sparkle-unitn/ELS-overall_schematic/README.md

# ELS-overall_schematic
Overall schematic of SpARKLE electronic subsystem
