sparkle-unitn/ELS-overall_schematic/ELS-overall_schematic.pdf

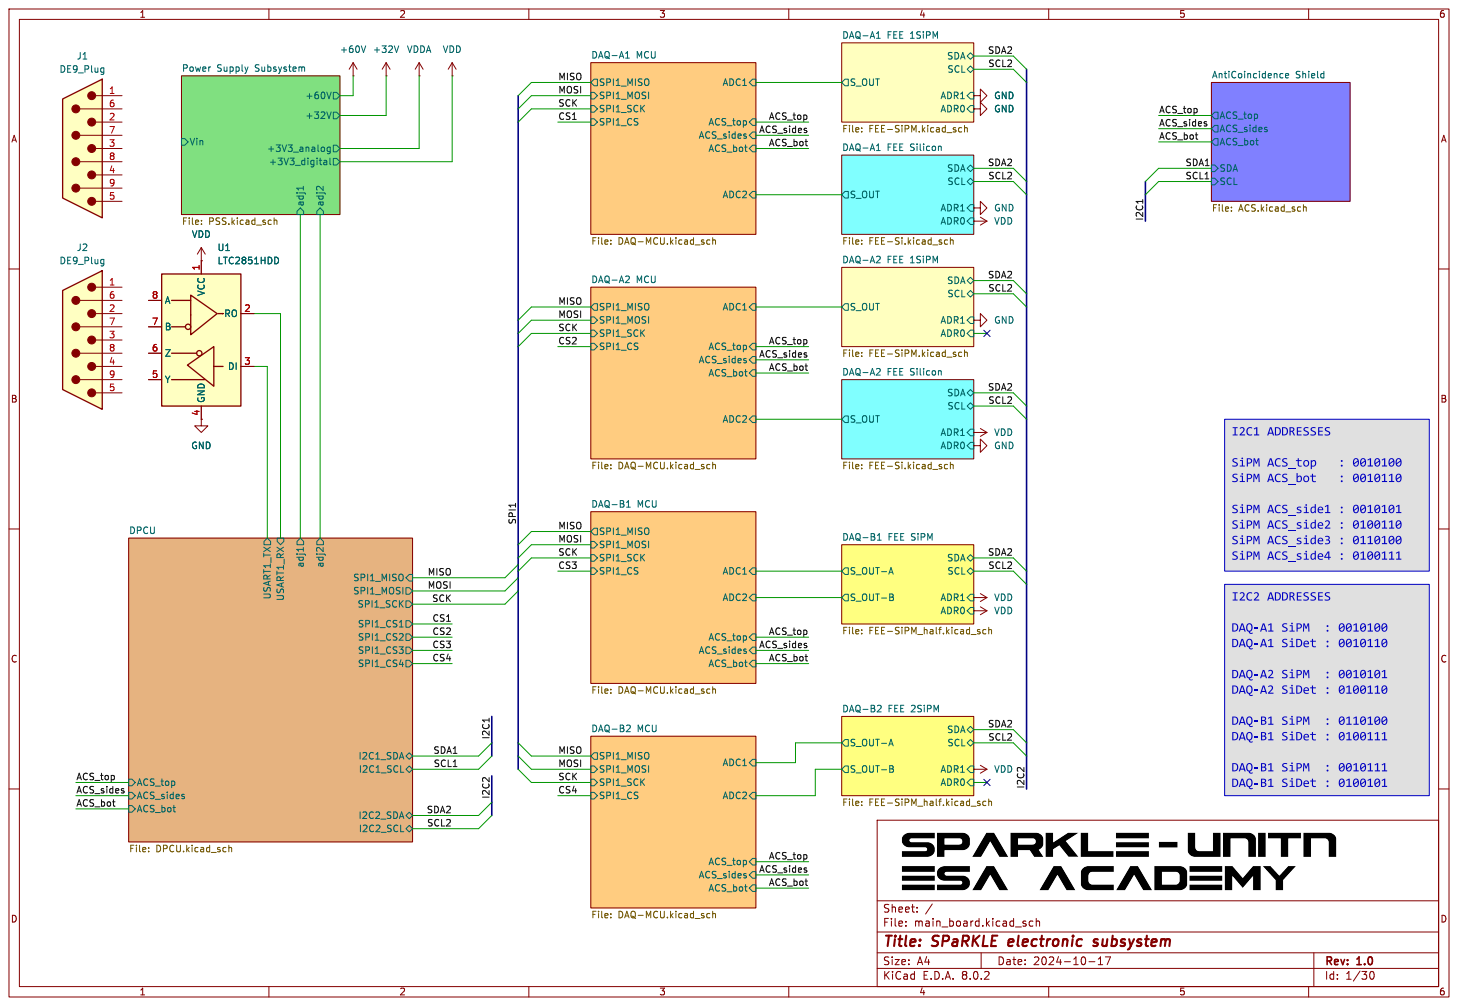
[picture p1: page 1]

Vin Power Supply Subsystem

SCL ADR0 ADR1 DAQ-A2 FEE Silicon File: FEE-Si.kicad_sch SCL SDA

Id: 1/30 Title: SPaRKLE electronic subsystem

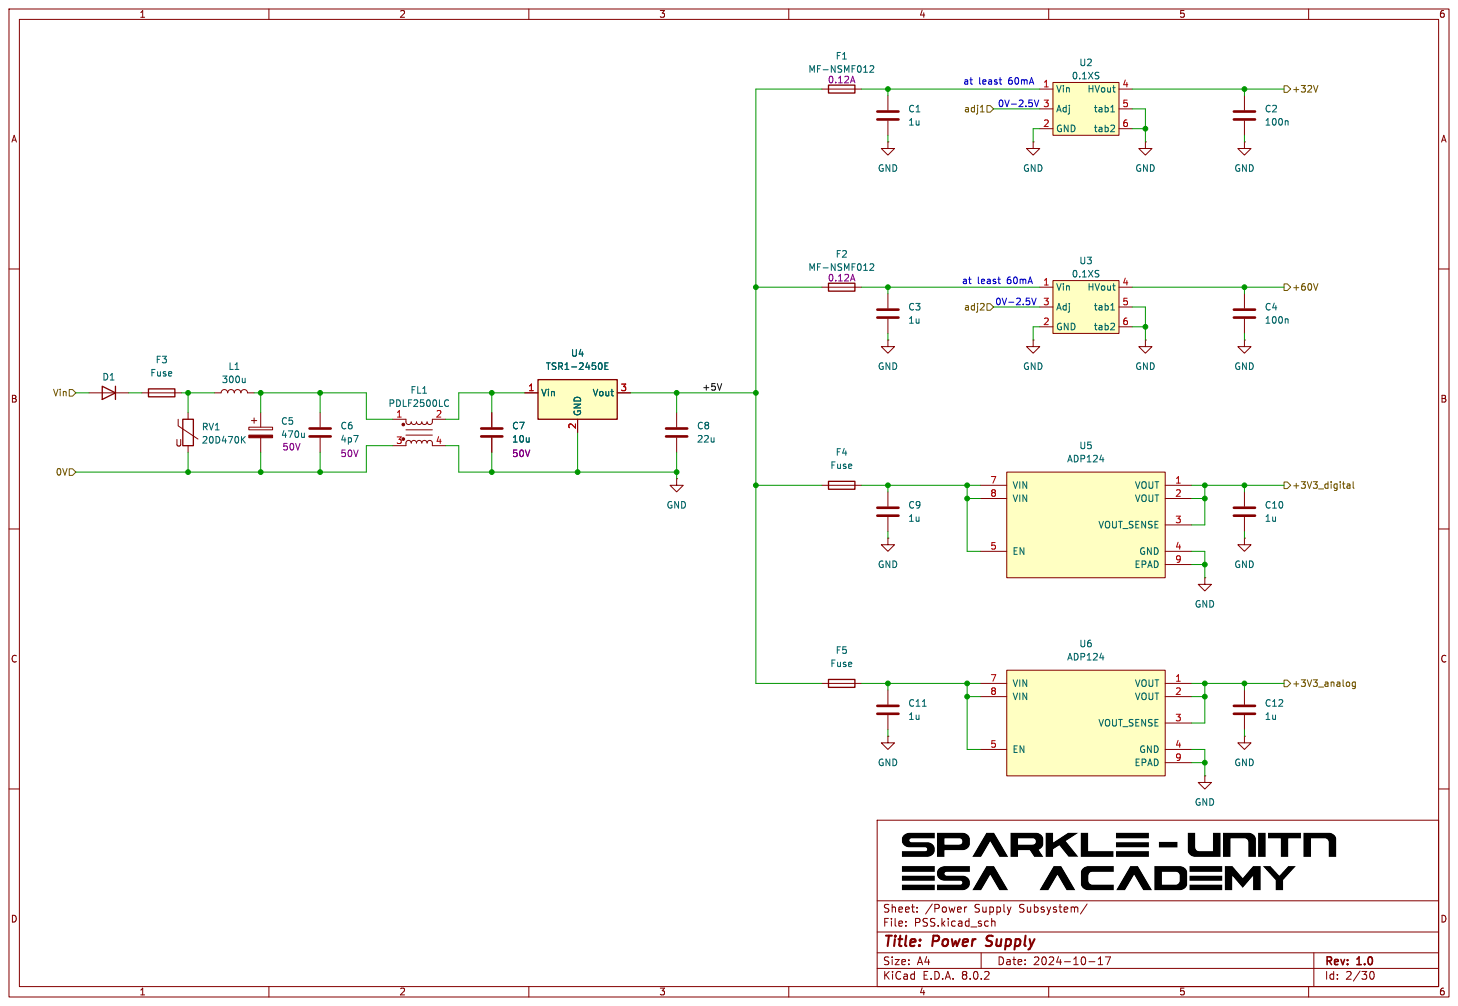
[picture p2: page 2]

Id: 2/30 Title: Power Supply

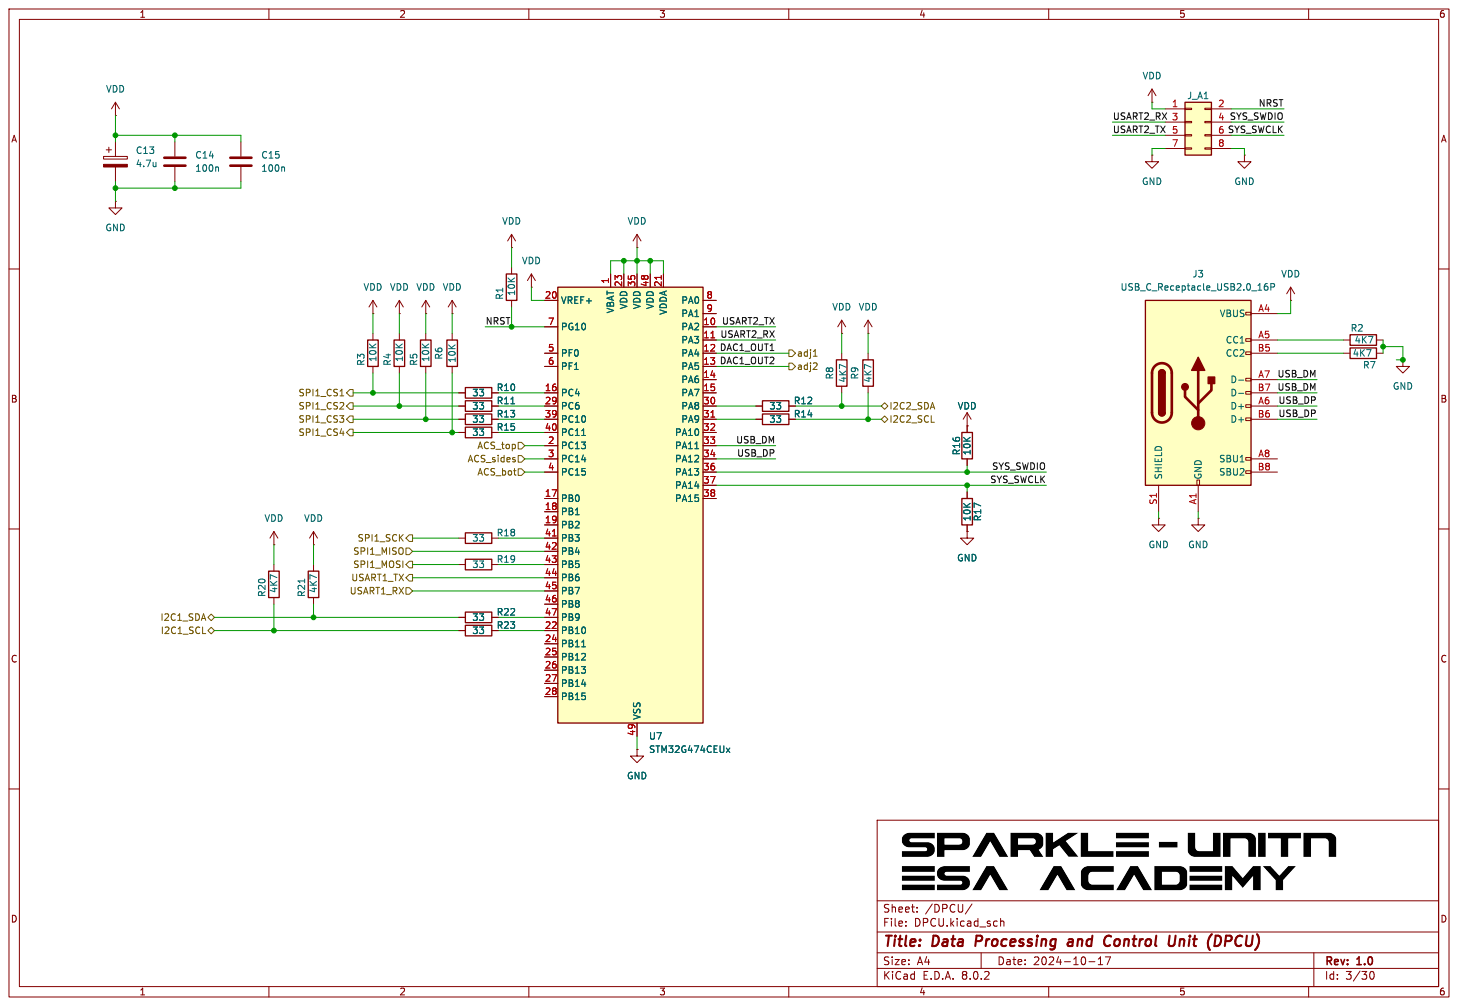
[picture p3: page 3]

1 PA2 10 PA3 11 PA4 12 PA5 13 PA6 14 PA7 15 PC4 16 PB0 17 PB1 18 PB2 19 PC13 2 VREF+ 20 VDDA 21 PB10 22 VDD 23 PB11 24 PB12 25 PB13 26 PB14 27 PB15 28 PC6 29 PC14 3 PA8 30 PA9 31 PA10 32 PA11 33 PA12 34 VDD 35 PA13 36 PA14 37 PA15 38 PC10 39 PC15 4 PC11 40 PB3 41 PB4 42 PB5 43 PB6 44 PB7 45 PB8 46 PB9 47 VDD 48 VSS 49 PF0 5 PF1 6 PG10 7 PA0 8 PA1 9 U7STM32G474CEUx

1 PA2 10 PA3 11 PA4 12 PA5 13 PA6 14 PA7 15 PC4 16 PB0 17 PB1 18 PB2 19 PC13 2 VREF+ 20 VDDA 21 PB10 22 VDD 23 PB11 24 PB12 25 PB13 26 PB14 27 PB15 28 PC6 29 PC14 3 PA8 30 PA9 31 PA10 32 PA11 33 PA12 34 VDD 35 PA13 36 PA14 37 PA15 38 PC10 39 PC15 4 PC11 40 PB3 41 PB4 42 PB5 43 PB6 44 PB7 45 PB8 46 PB9 47 VDD 48 VSS 49 PF0 5 PF1 6 PG10 7 PA0 8 PA1 9 R14 33 R12 33 GND

Id: 3/30 Title: Data Processing and Control Unit (DPCU) File: DPCU.kicad_sch Sheet: /DPCU/

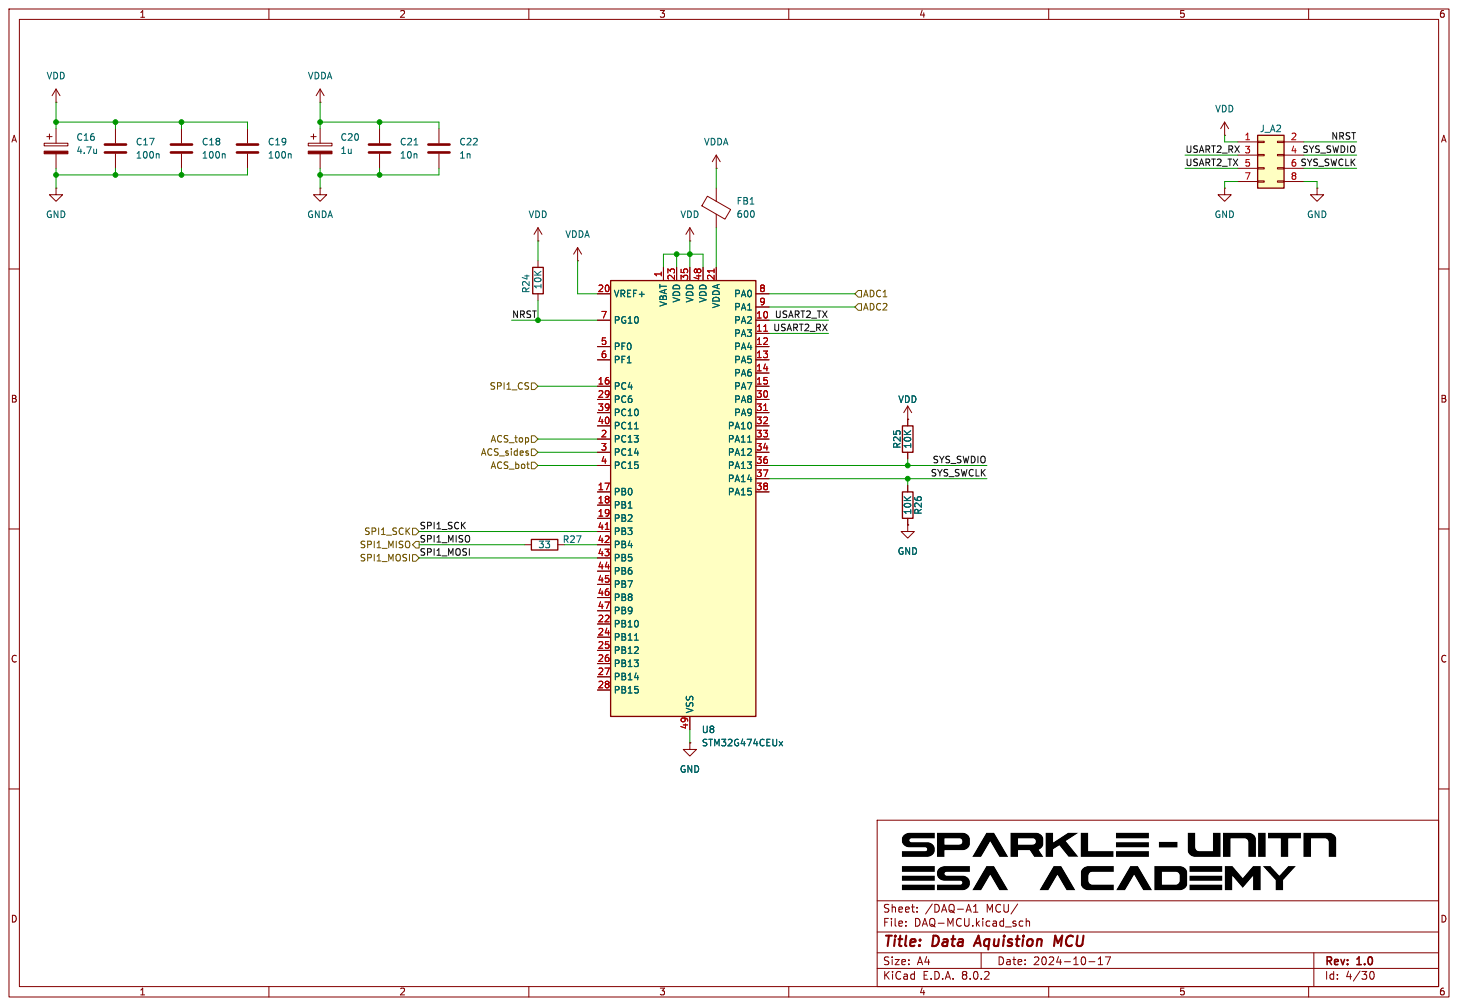
[picture p4: page 4]

1 PA2 10 PA3 11 PA4 12 PA5 13 PA6 14 PA7 15 PC4 16 PB0 17 PB1 18 PB2 19 PC13 2 VREF+ 20 VDDA 21 PB10 22 VDD 23 PB11 24 PB12 25 PB13 26 PB14 27 PB15 28 PC6 29 PC14 3 PA8 30 PA9 31 PA10 32 PA11 33 PA12 34 VDD 35 PA13 36 PA14 37 PA15 38 PC10 39 PC15 4 PC11 40 PB3 41 PB4 42 PB5 43 PB6 44 PB7 45 PB8 46 PB9 47 VDD 48 VSS 49 PF0 5 PF1 6 PG10 7 PA0 8 PA1 9 U8STM32G474CEUx

1 PA2 10 PA3 11 PA4 12 PA5 13 PA6 14 PA7 15 PC4 16 PB0 17 PB1 18 PB2 19 PC13 2 VREF+ 20 VDDA 21 PB10 22 VDD 23 PB11 24 PB12 25 PB13 26 PB14 27 PB15 28 PC6 29 PC14 3 PA8 30 PA9 31 PA10 32 PA11 33 PA12 34 VDD 35 PA13 36 PA14 37 PA15 38 PC10 39 PC15 4 PC11 40 PB3 41 PB4 42 PB5 43 PB6 44 PB7 45 PB8 46 PB9 47 VDD 48 VSS 49 PF0 5 PF1 6 PG10 7 PA0 8 PA1 9 GND10K R26 VDD R25 10K

Id: 4/30 Title: Data Aquistion MCU

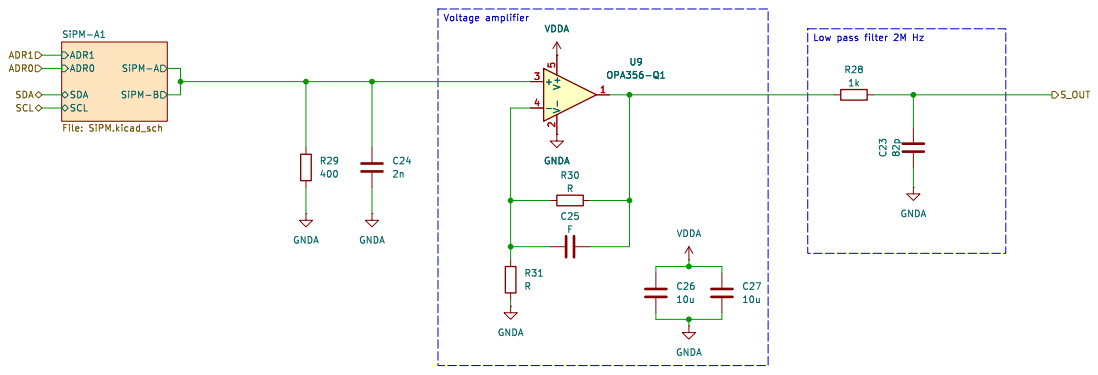
[picture p5: page 5]

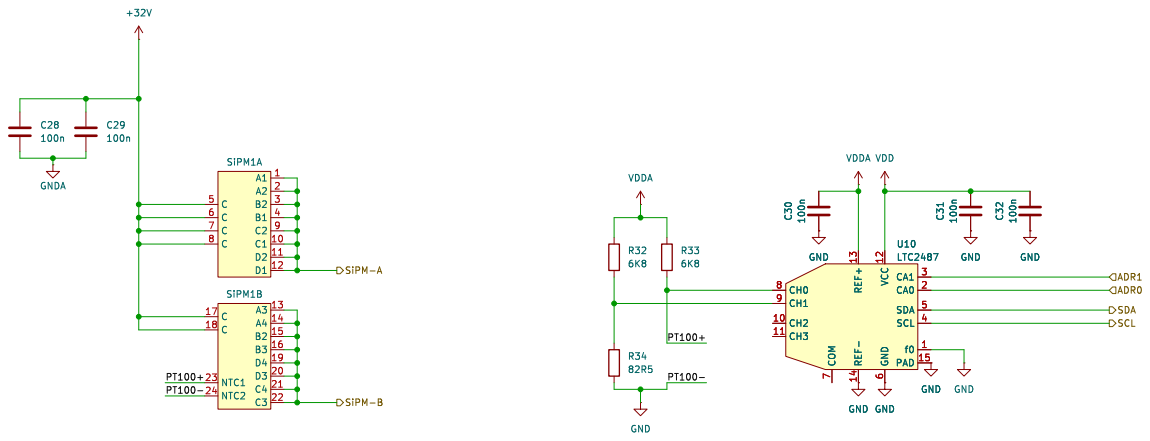
[picture p6: page 6]

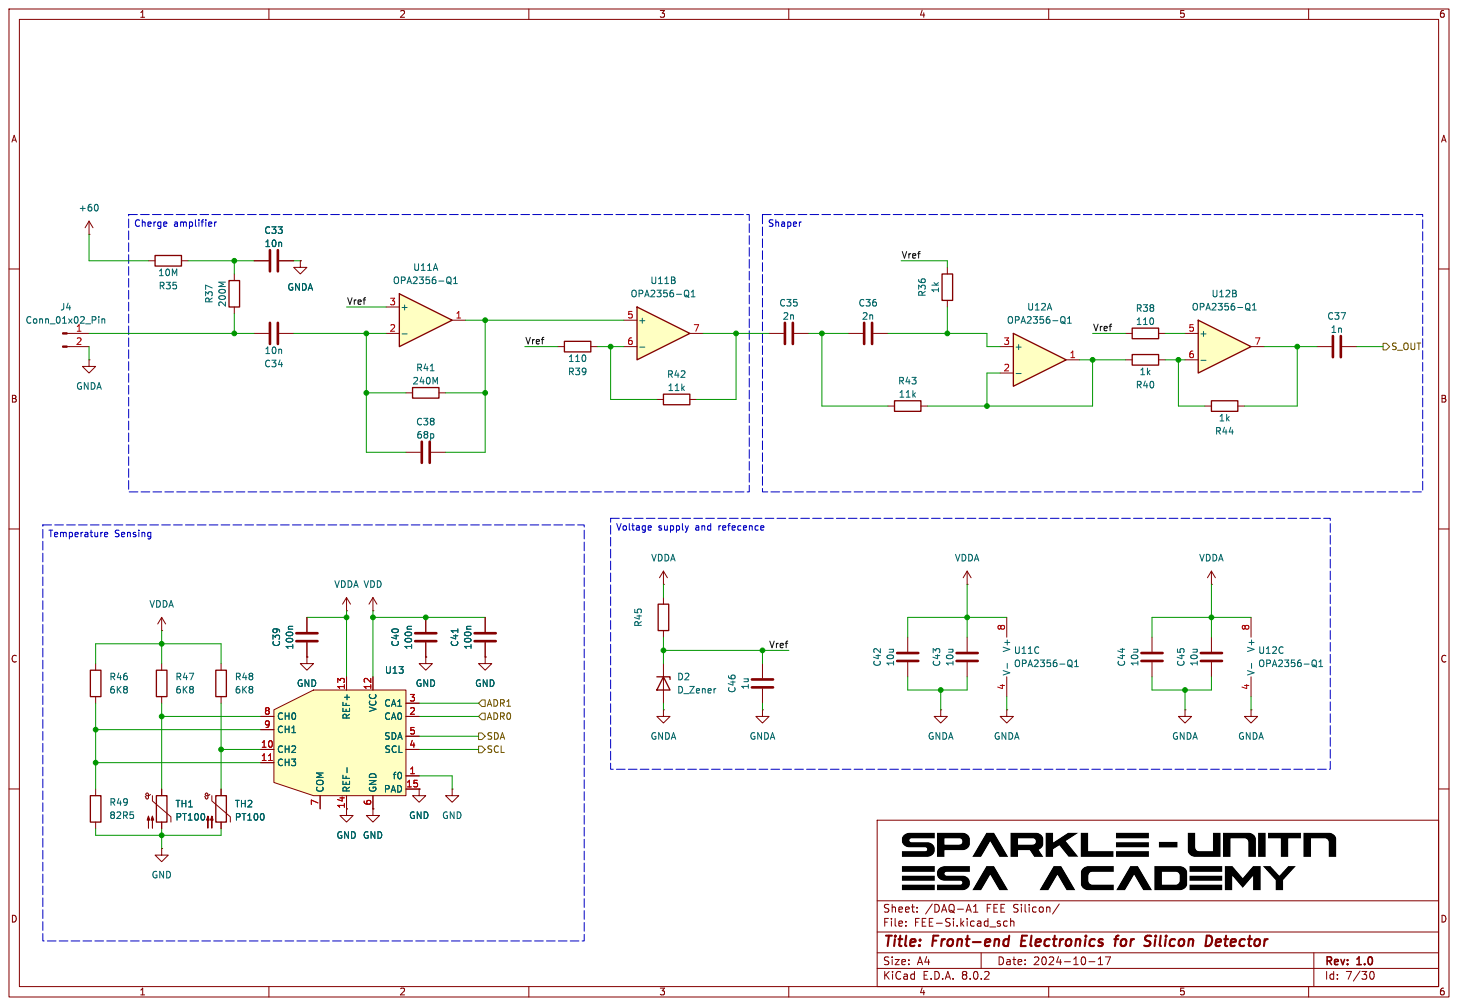
[picture p7: page 7]

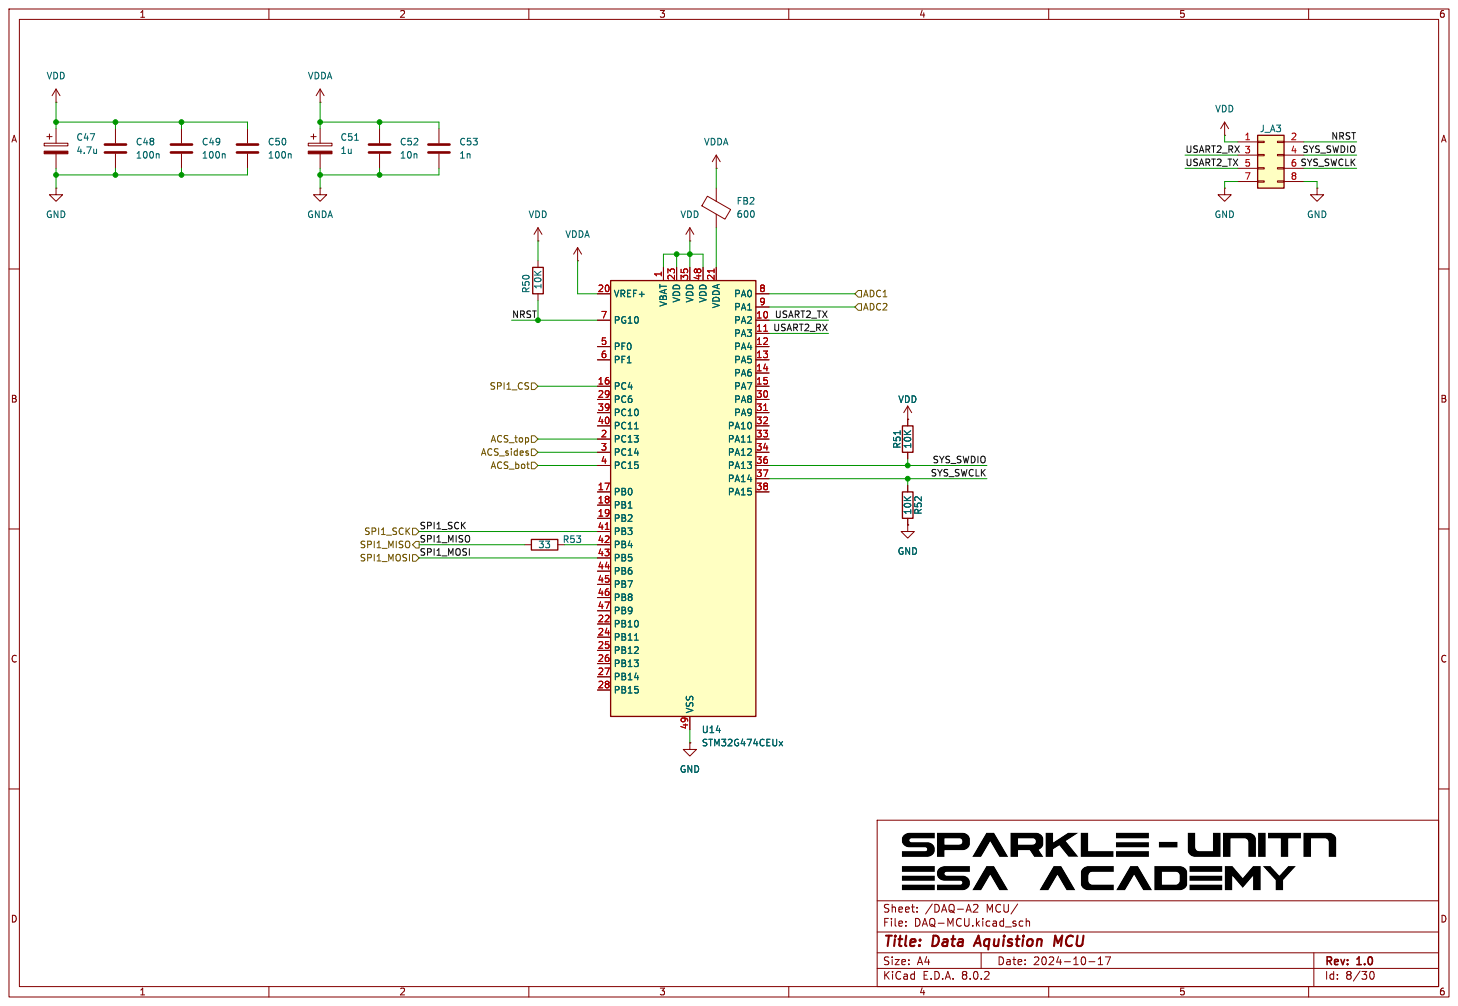
[picture p8: page 8]

1 PA2 10 PA3 11 PA4 12 PA5 13 PA6 14 PA7 15 PC4 16 PB0 17 PB1 18 PB2 19 PC13 2 VREF+ 20 VDDA 21 PB10 22 VDD 23 PB11 24 PB12 25 PB13 26 PB14 27 PB15 28 PC6 29 PC14 3 PA8 30 PA9 31 PA10 32 PA11 33 PA12 34 VDD 35 PA13 36 PA14 37 PA15 38 PC10 39 PC15 4 PC11 40 PB3 41 PB4 42 PB5 43 PB6 44 PB7 45 PB8 46 PB9 47 VDD 48 VSS 49 PF0 5 PF1 6 PG10 7 PA0 8 PA1 9 U14 STM32G474CEUx

1 PA2 10 PA3 11 PA4 12 PA5 13 PA6 14 PA7 15 PC4 16 PB0 17 PB1 18 PB2 19 PC13 2 VREF+ 20 VDDA 21 PB10 22 VDD 23 PB11 24 PB12 25 PB13 26 PB14 27 PB15 28 PC6 29 PC14 3 PA8 30 PA9 31 PA10 32 PA11 33 PA12 34 VDD 35 PA13 36 PA14 37 PA15 38 PC10 39 PC15 4 PC11 40 PB3 41 PB4 42 PB5 43 PB6 44 PB7 45 PB8 46 PB9 47 VDD 48 VSS 49 PF0 5 PF1 6 PG10 7 PA0 8 PA1 9 GND10K R52 VDD R51 10K

Id: 8/30 Title: Data Aquistion MCU

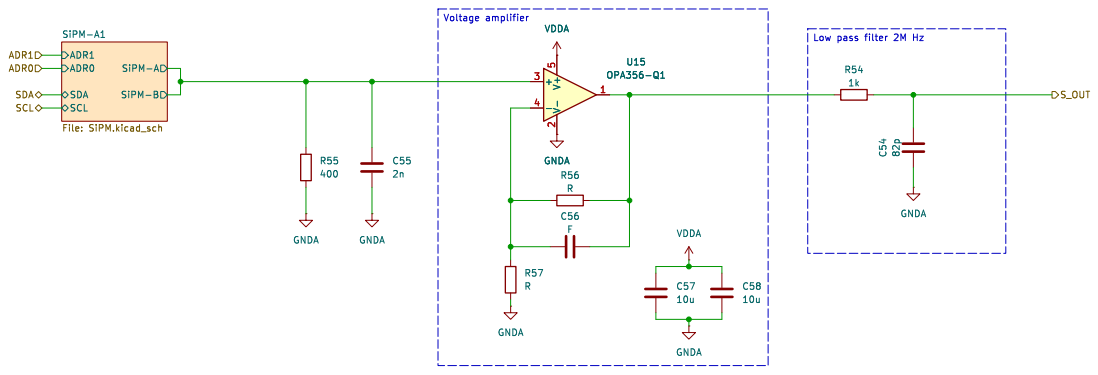
[picture p9: page 9]

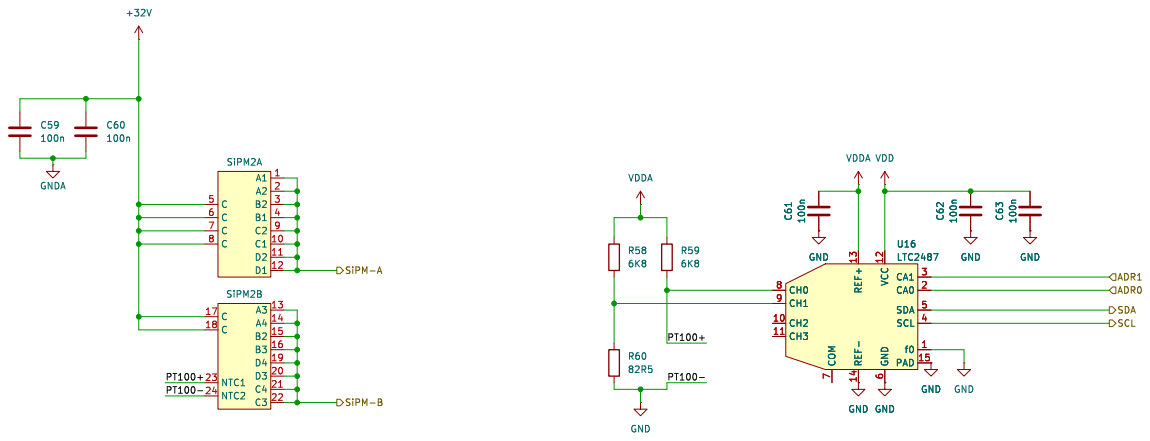
[picture p10: page 10]

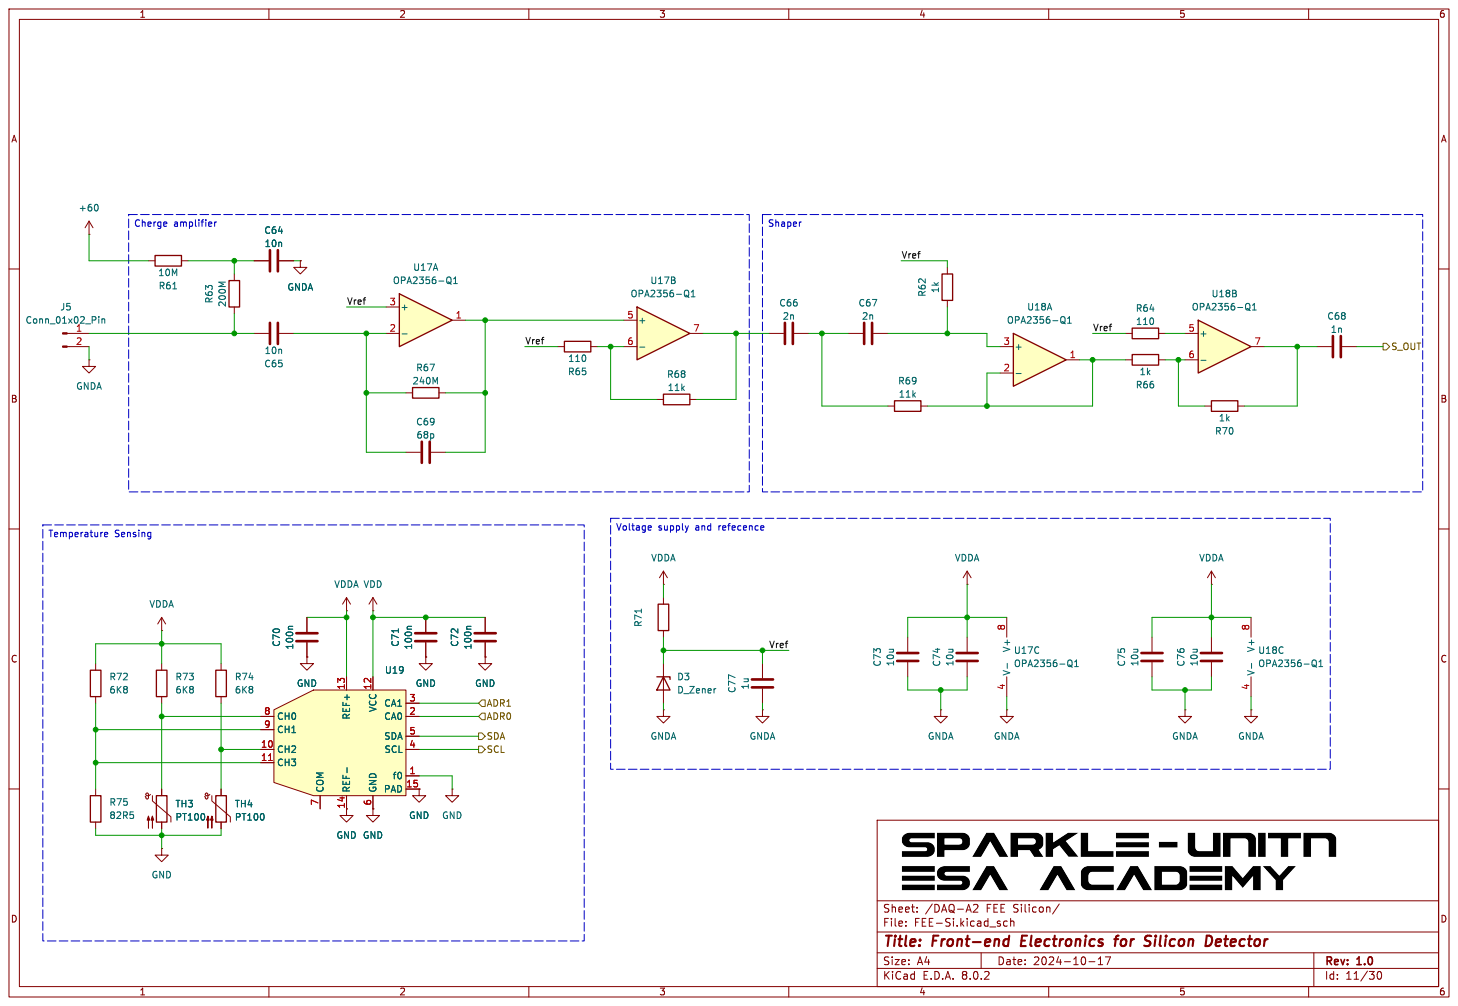
[picture p11: page 11]

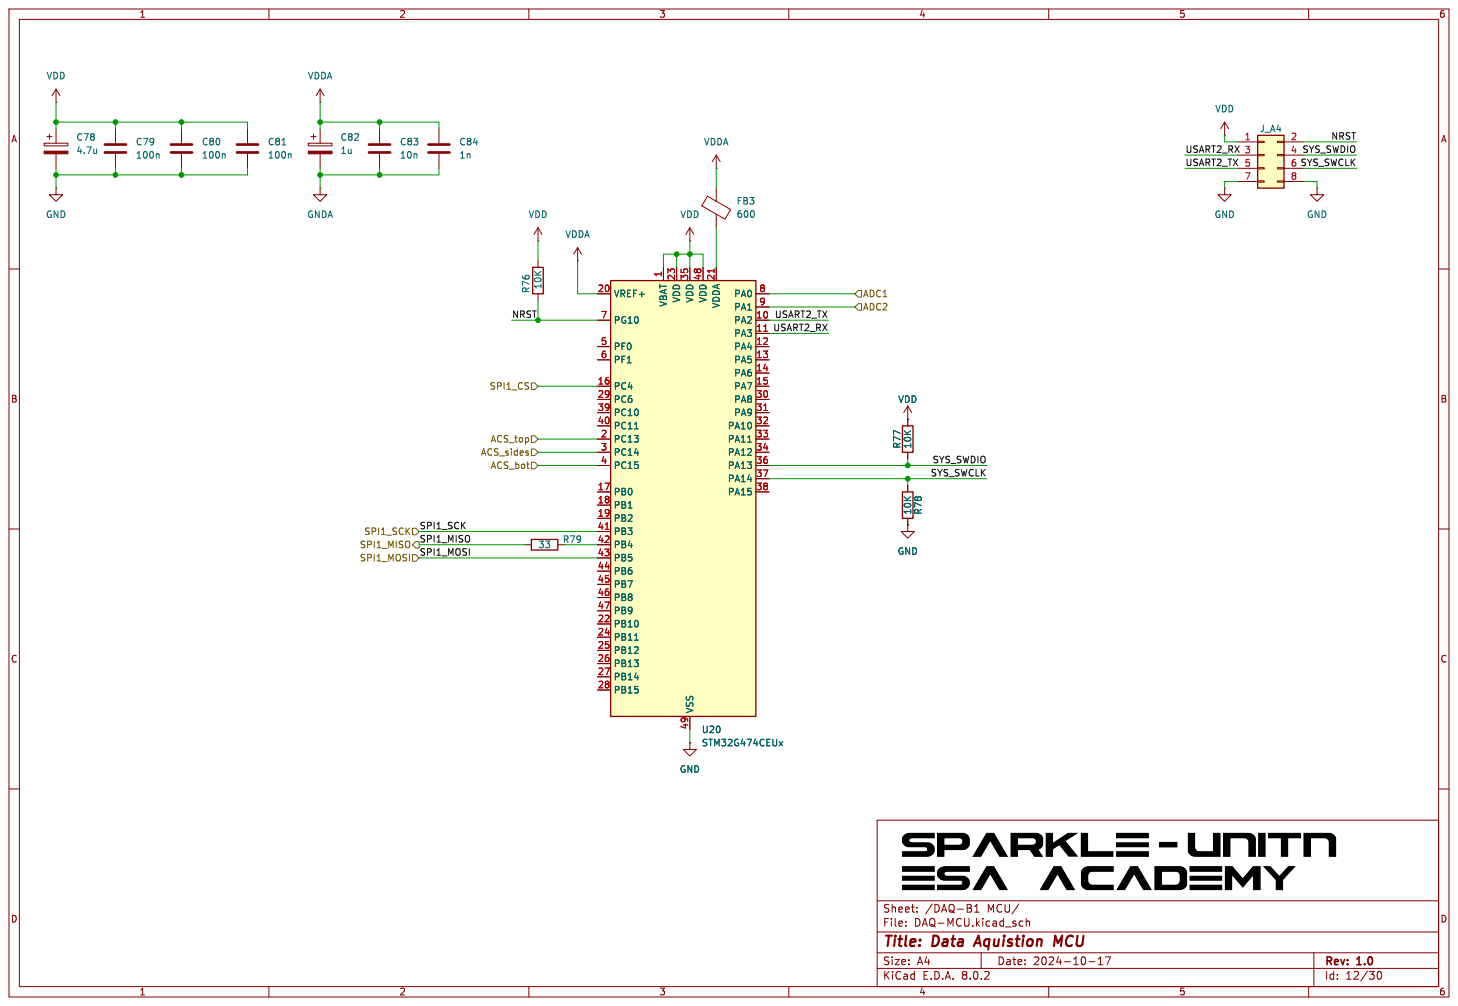
[picture p12: page 12]

1 PA2 10 PA3 11 PA4 12 PA5 13 PA6 14 PA7 15 PC4 16 PB0 17 PB1 18 PB2 19 PC13 2 VREF+ 20 VDDA 21 PB10 22 VDD 23 PB11 24 PB12 25 PB13 26 PB14 27 PB15 28 PC6 29 PC14 3 PA8 30 PA9 31 PA10 32 PA11 33 PA12 34 VDD 35 PA13 36 PA14 37 PA15 38 PC10 39 PC15 4 PC11 40 PB3 41 PB4 42 PB5 43 PB6 44 PB7 45 PB8 46 PB9 47 VDD 48 VSS 49 PF0 5 PF1 6 PG10 7 PA0 8 PA1 9 U20 STM32G474CEUx

1 PA2 10 PA3 11 PA4 12 PA5 13 PA6 14 PA7 15 PC4 16 PB0 17 PB1 18 PB2 19 PC13 2 VREF+ 20 VDDA 21 PB10 22 VDD 23 PB11 24 PB12 25 PB13 26 PB14 27 PB15 28 PC6 29 PC14 3 PA8 30 PA9 31 PA10 32 PA11 33 PA12 34 VDD 35 PA13 36 PA14 37 PA15 38 PC10 39 PC15 4 PC11 40 PB3 41 PB4 42 PB5 43 PB6 44 PB7 45 PB8 46 PB9 47 VDD 48 VSS 49 PF0 5 PF1 6 PG10 7 PA0 8 PA1 9 GND10K R78 VDD R77 10K

Id: 12/30 Title: Data Aquistion MCU

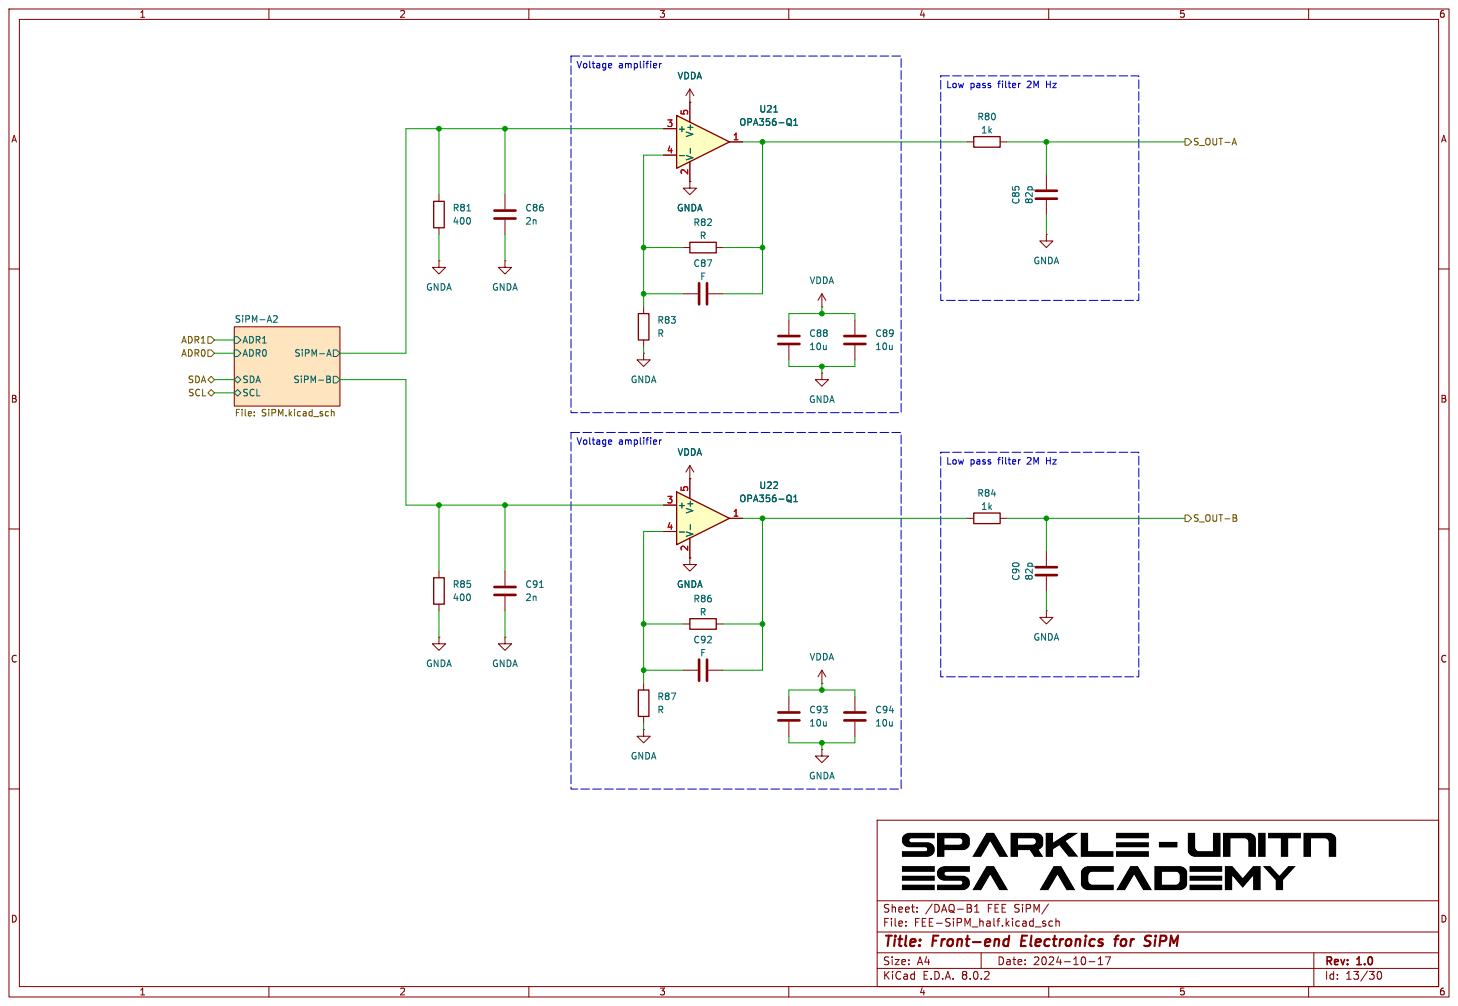
[picture p13: page 13]

Low pass filter 2M Hz U21 OPA356-Q1 V- 2 V+

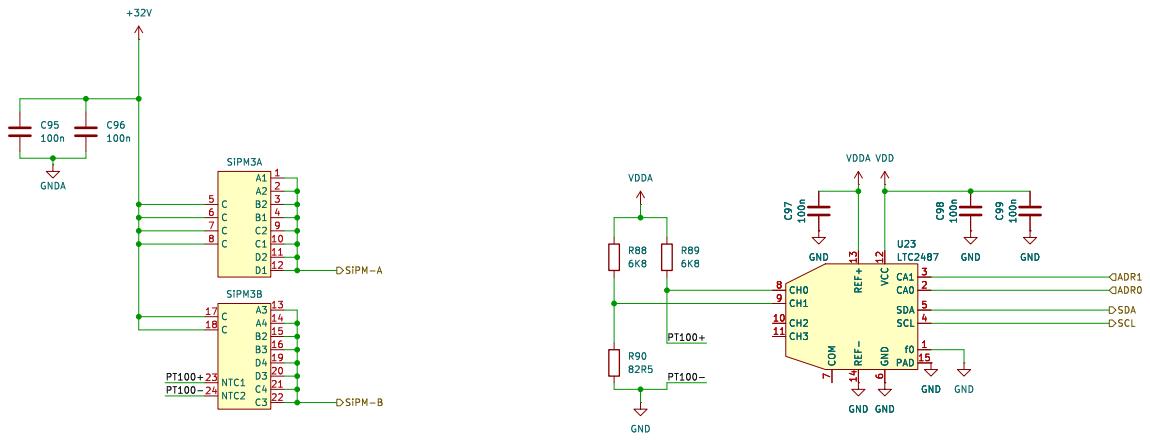
[picture p14: page 14]

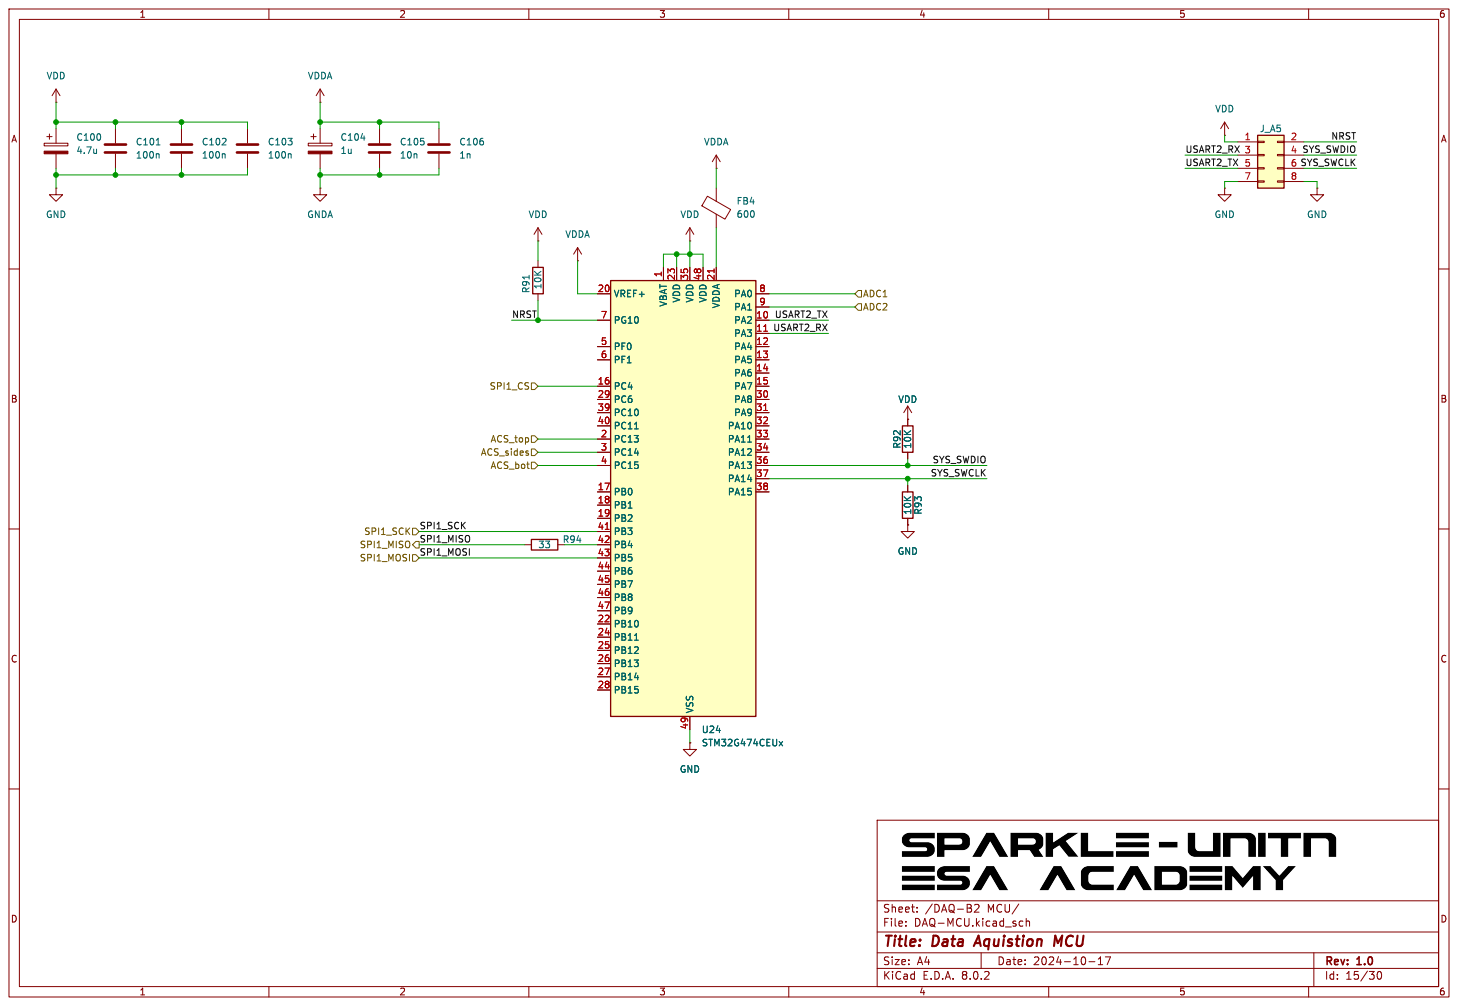
[picture p15: page 15]

1 PA2 10 PA3 11 PA4 12 PA5 13 PA6 14 PA7 15 PC4 16 PB0 17 PB1 18 PB2 19 PC13 2 VREF+ 20 VDDA 21 PB10 22 VDD 23 PB11 24 PB12 25 PB13 26 PB14 27 PB15 28 PC6 29 PC14 3 PA8 30 PA9 31 PA10 32 PA11 33 PA12 34 VDD 35 PA13 36 PA14 37 PA15 38 PC10 39 PC15 4 PC11 40 PB3 41 PB4 42 PB5 43 PB6 44 PB7 45 PB8 46 PB9 47 VDD 48 VSS 49 PF0 5 PF1 6 PG10 7 PA0 8 PA1 9 U24 STM32G474CEUx

1 PA2 10 PA3 11 PA4 12 PA5 13 PA6 14 PA7 15 PC4 16 PB0 17 PB1 18 PB2 19 PC13 2 VREF+ 20 VDDA 21 PB10 22 VDD 23 PB11 24 PB12 25 PB13 26 PB14 27 PB15 28 PC6 29 PC14 3 PA8 30 PA9 31 PA10 32 PA11 33 PA12 34 VDD 35 PA13 36 PA14 37 PA15 38 PC10 39 PC15 4 PC11 40 PB3 41 PB4 42 PB5 43 PB6 44 PB7 45 PB8 46 PB9 47 VDD 48 VSS 49 PF0 5 PF1 6 PG10 7 PA0 8 PA1 9 GND10K R93 VDD R92 10K

Id: 15/30 Title: Data Aquistion MCU

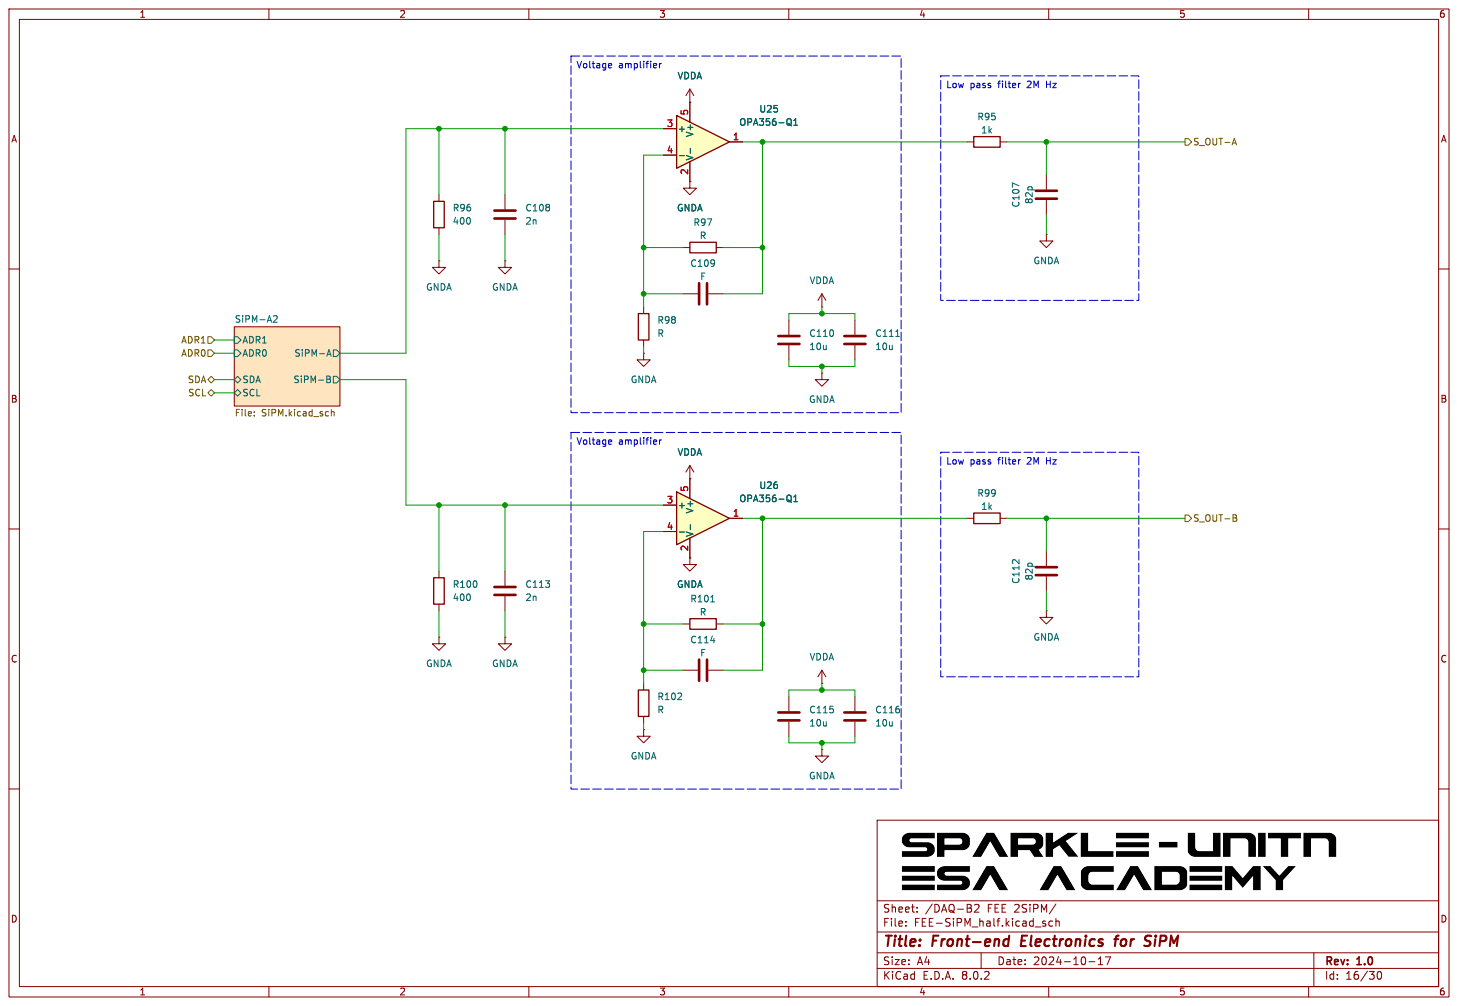
[picture p16: page 16]

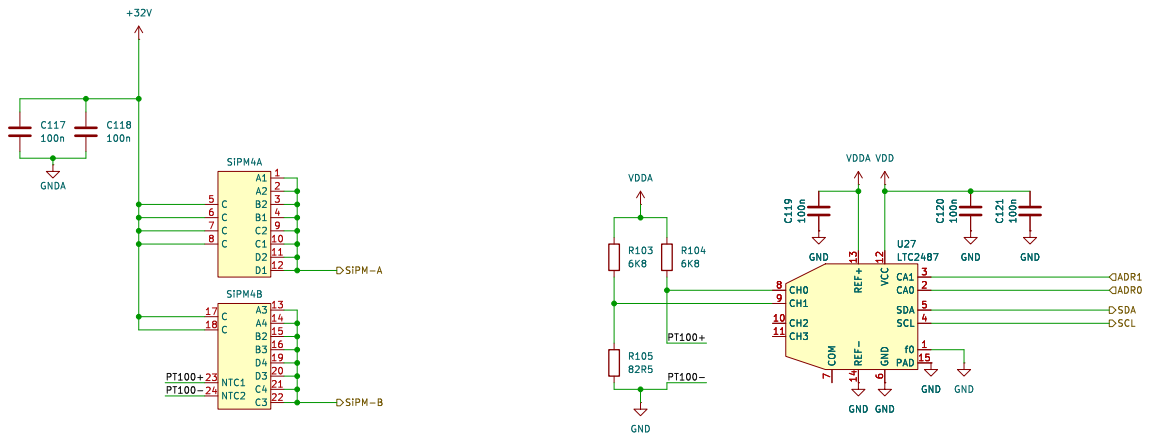
[picture p17: page 17]

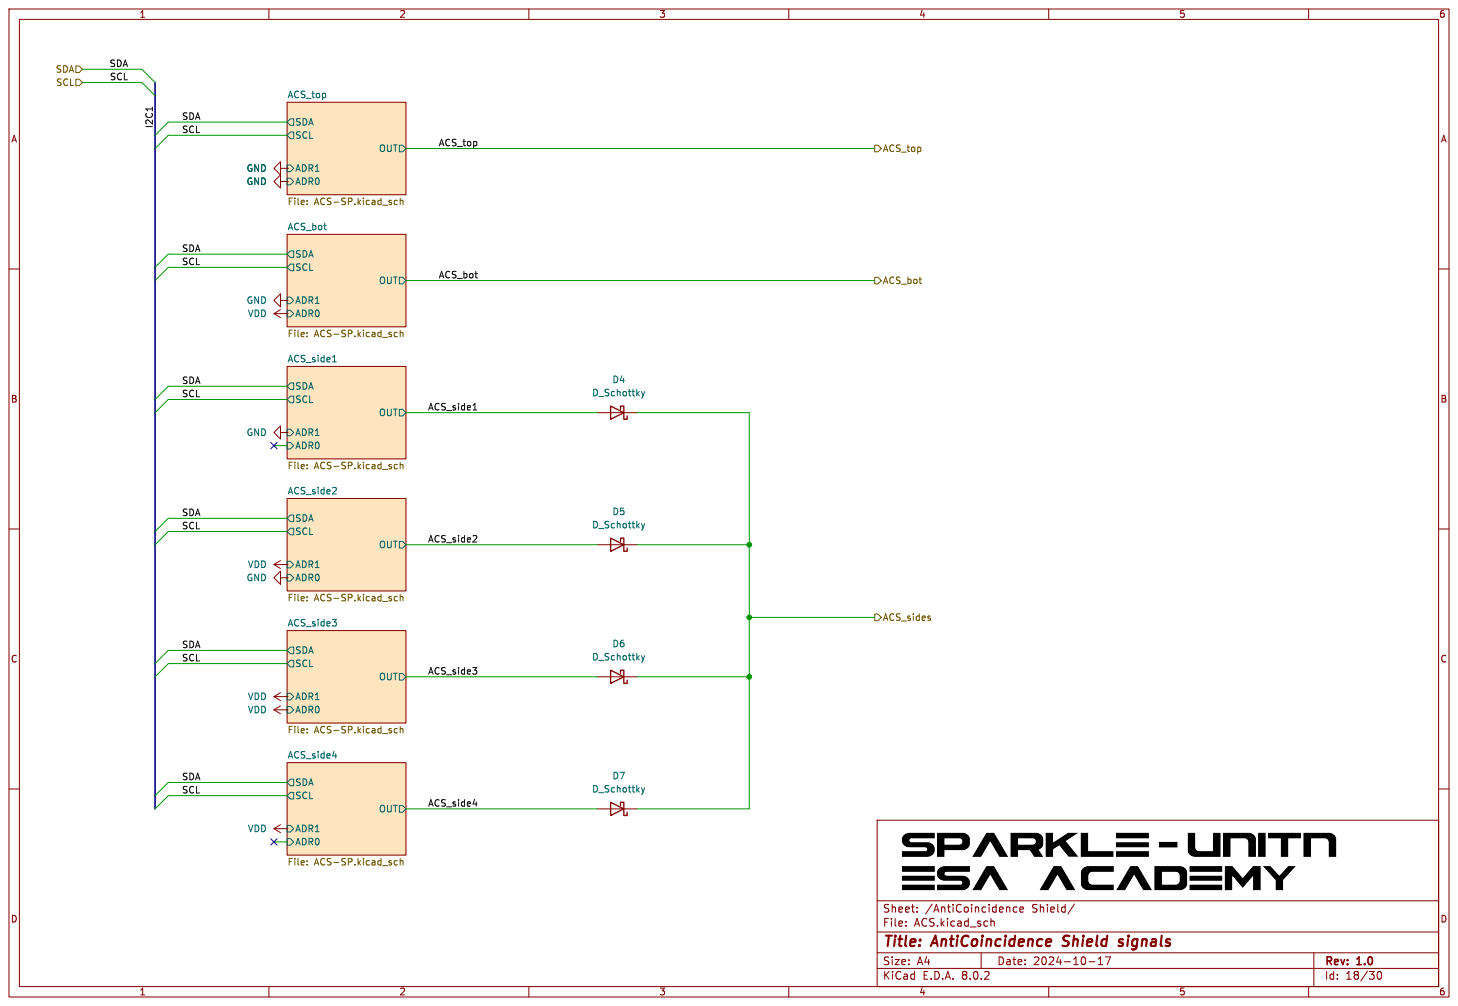
[picture p18: page 18]

ADR0 ADR1 ACS_top File: ACS-SP.kicad_sch OUT SCL SDA
ADR0 ADR1 ACS_bot File: ACS-SP.kicad_sch OUT SCL SDA
ADR0 ADR1 ACS_side1 File: ACS-SP.kicad_sch OUT SCL SDA

D7 D_Schottky D6 D_Schottky GND GND
ADR0 ADR1 ACS_side4 File: ACS-SP.kicad_sch VDD

ADR0 ADR1 ACS_side2 File: ACS-SP.kicad_sch OUT SCL SDA

ADR0 ADR1 ACS_side3 File: ACS-SP.kicad_sch OUT SCL SDA

Id: 18/30 Title: AntiCoincidence Shield signals

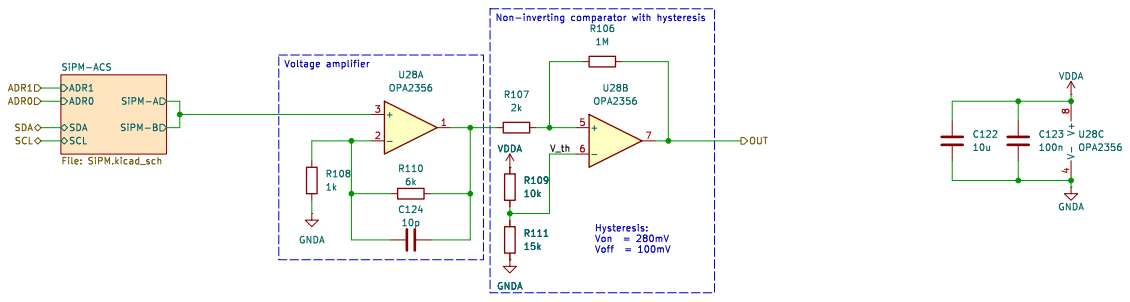
[picture p19: page 19]

Id: 19/30 Title: ACS signal conditioning

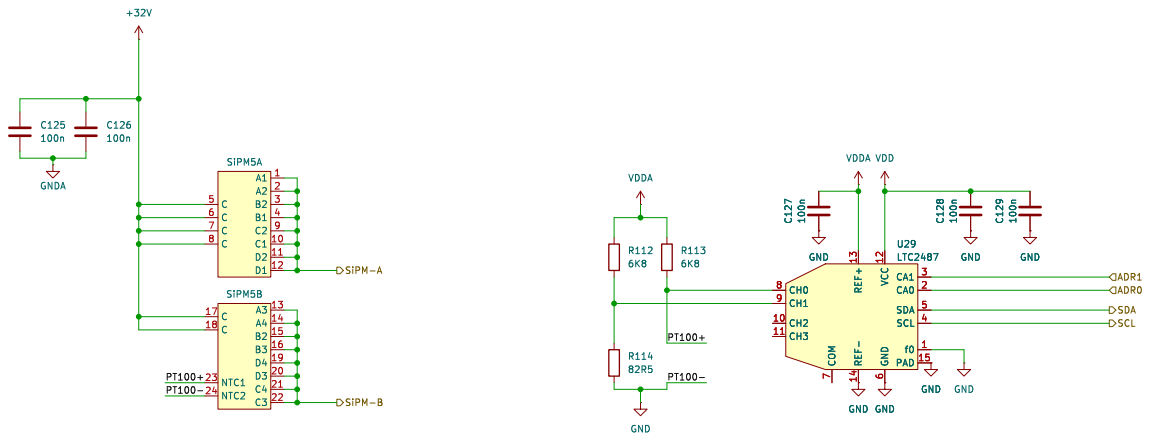
[picture p20: page 20]

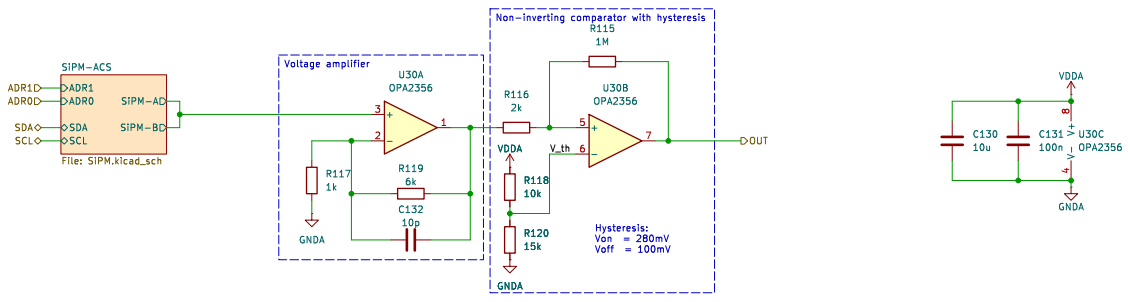
[picture p21: page 21]

Id: 21/30 Title: ACS signal conditioning

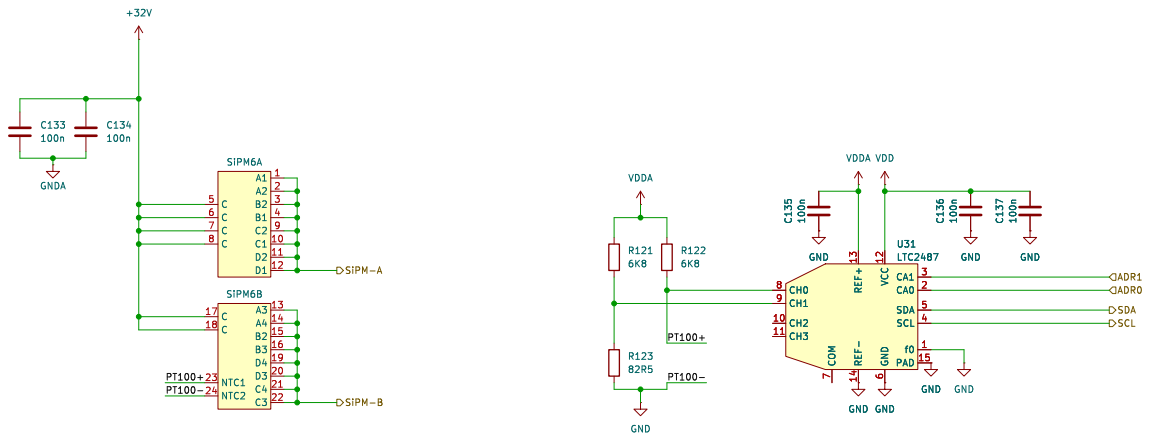
[picture p22: page 22]

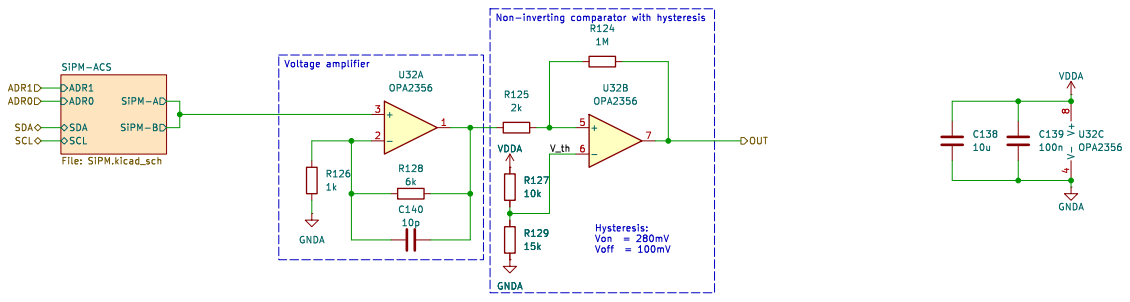
[picture p23: page 23]

Id: 23/30 Title: ACS signal conditioning

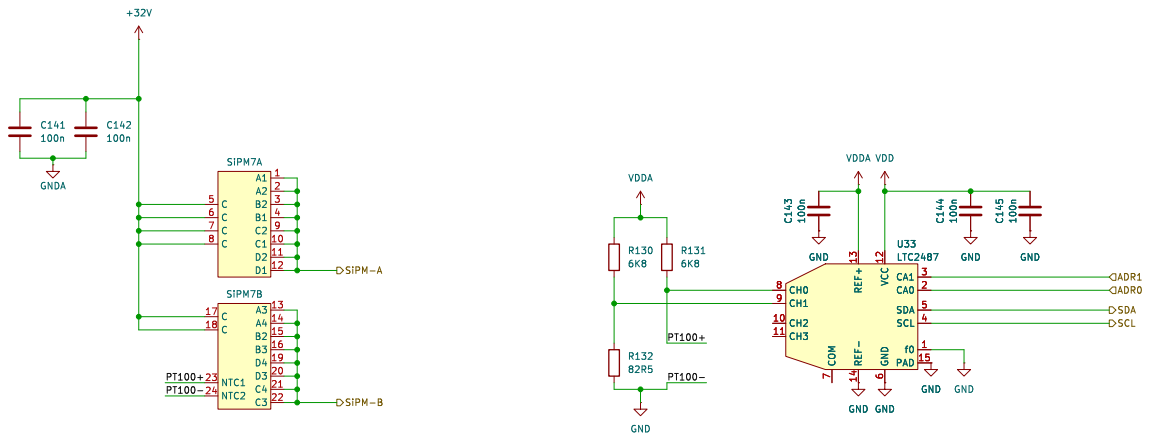
[picture p24: page 24]

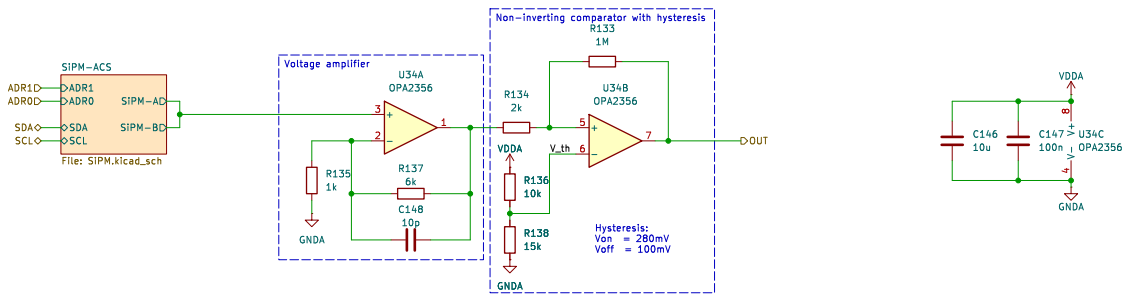
[picture p25: page 25]

Id: 25/30 Title: ACS signal conditioning

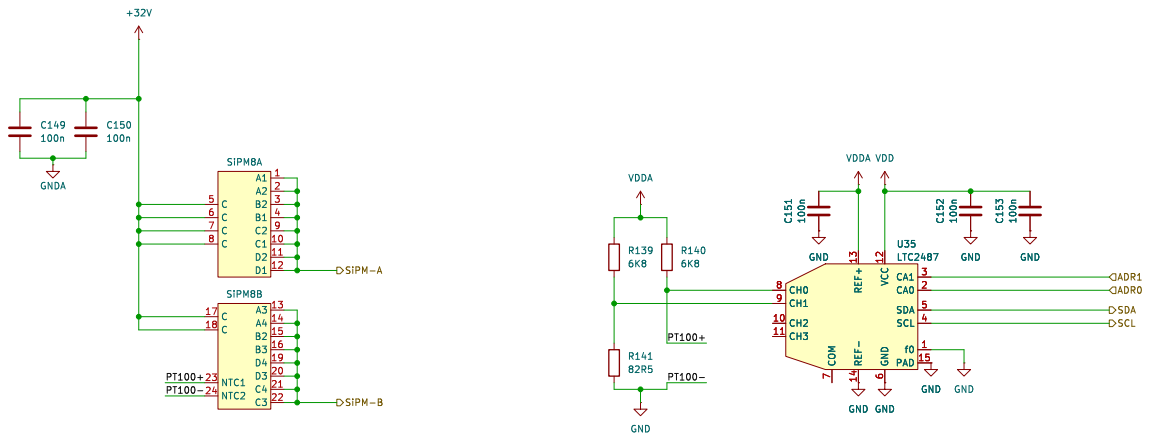
[picture p26: page 26]

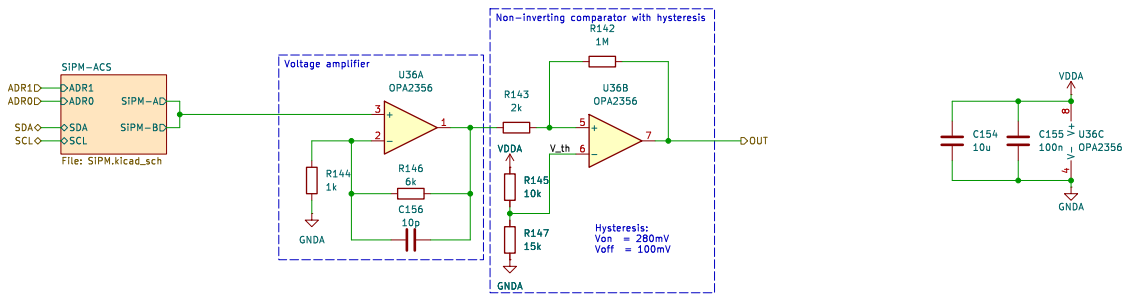
[picture p27: page 27]

Id: 27/30 Title: ACS signal conditioning

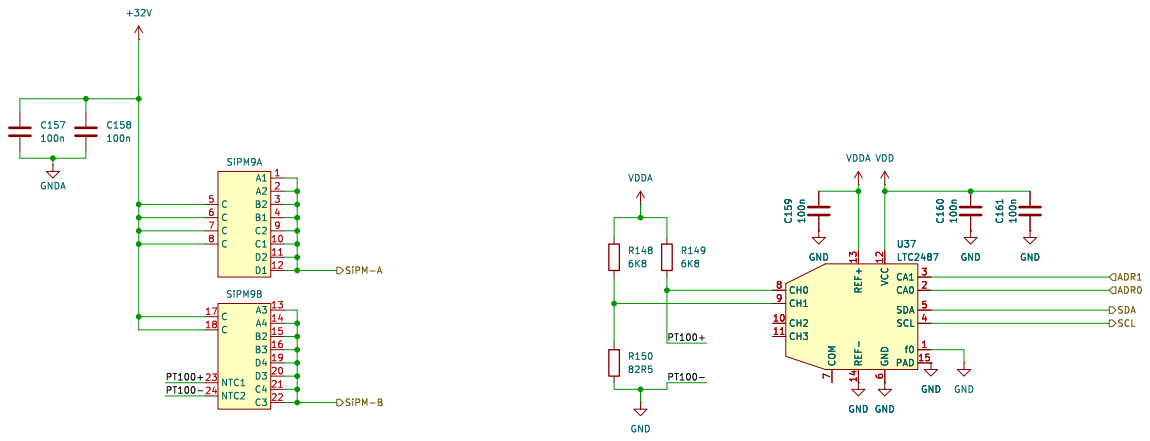
[picture p28: page 28]

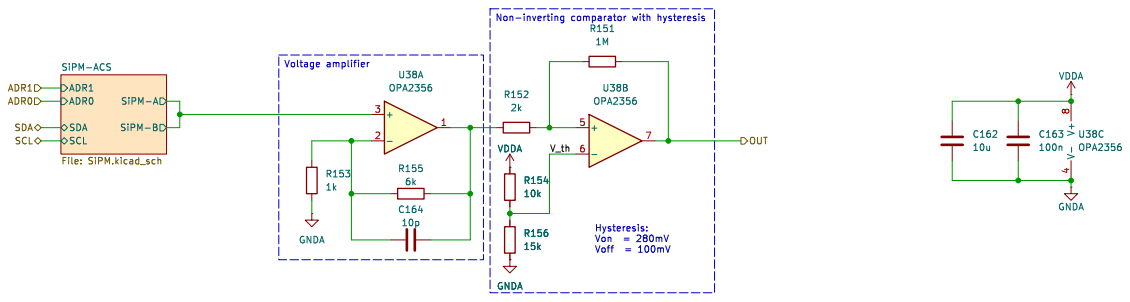
[picture p29: page 29]

Id: 29/30 Title: ACS signal conditioning

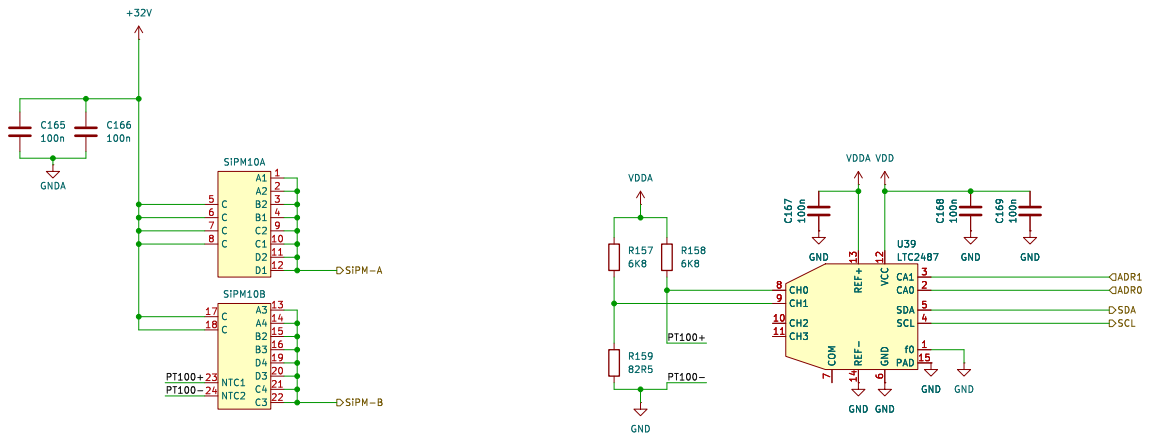
[picture p30: page 30]
