sparkle-unitn/ELS-overall_schematic/ACS-SP.kicad_sch

## KiCad design ACS-SP.kicad_sch (2024-10-17)

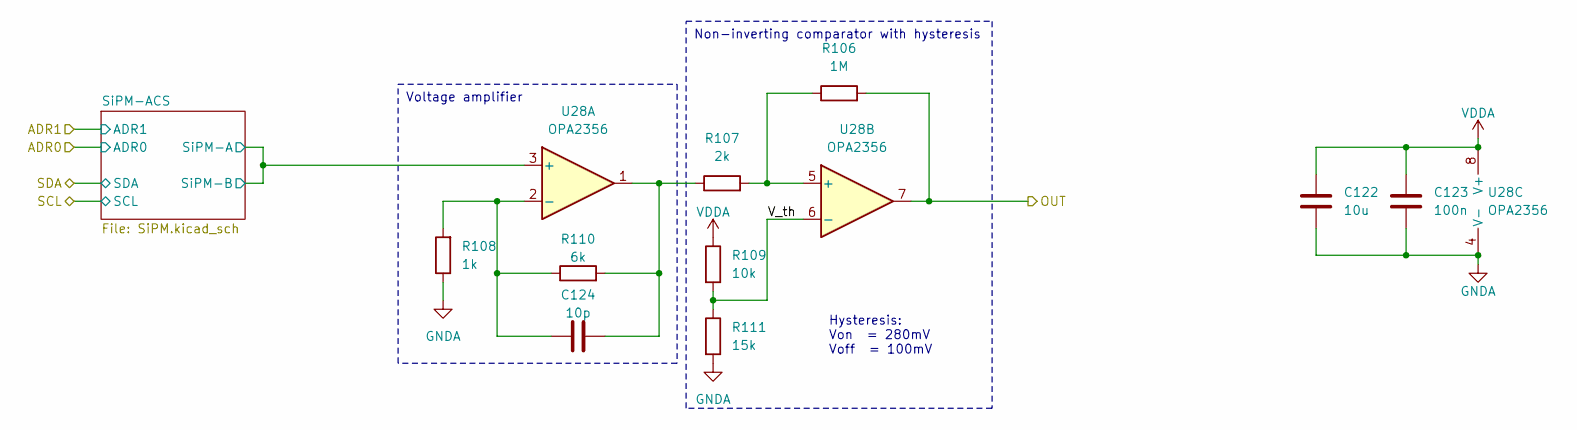
[picture p31: schematic ACS-SP.kicad_sch]

Parts:
C122: 10u
C123: 100n
C124: 10p; C_0603_1608Metric_Pad1.08x0.95mm_HandSolder
R106: 1M
R107: 2k
R108: 1k; R_0603_1608Metric_Pad0.98x0.95mm_HandSolder
R109: 10k
R110: 6k; R_0603_1608Metric_Pad0.98x0.95mm_HandSolder
R111: 15k
U28: OPA2356; LFCSP-8_2x2mm_P0.5mm

Connections:
GNDA: C122.2, C123.2, R108.1, R111.2, U28.4 (V-)
unnamed: C124.1, R108.2, R110.1, U28.2 (-)
unnamed: C124.2, R107.1, R110.2, U28.1
unnamed: R106.1, R107.2, U28.5 (+)
OUT: R106.2, U28.7
SiPM-A: U28.3 (+)
VDDA: C122.1, C123.1, R109.1, U28.8 (V+)
V_th: R109.2, R111.1, U28.6 (-)

Notes on the sheet:
Non-inverting comparator with hysteresis
Voltage amplifier
Hysteresis: Von = 280mV Voff = 100mV
