sparkle-unitn/ELS-overall_schematic/ACS.kicad_sch

## KiCad design ACS.kicad_sch (2024-10-17)

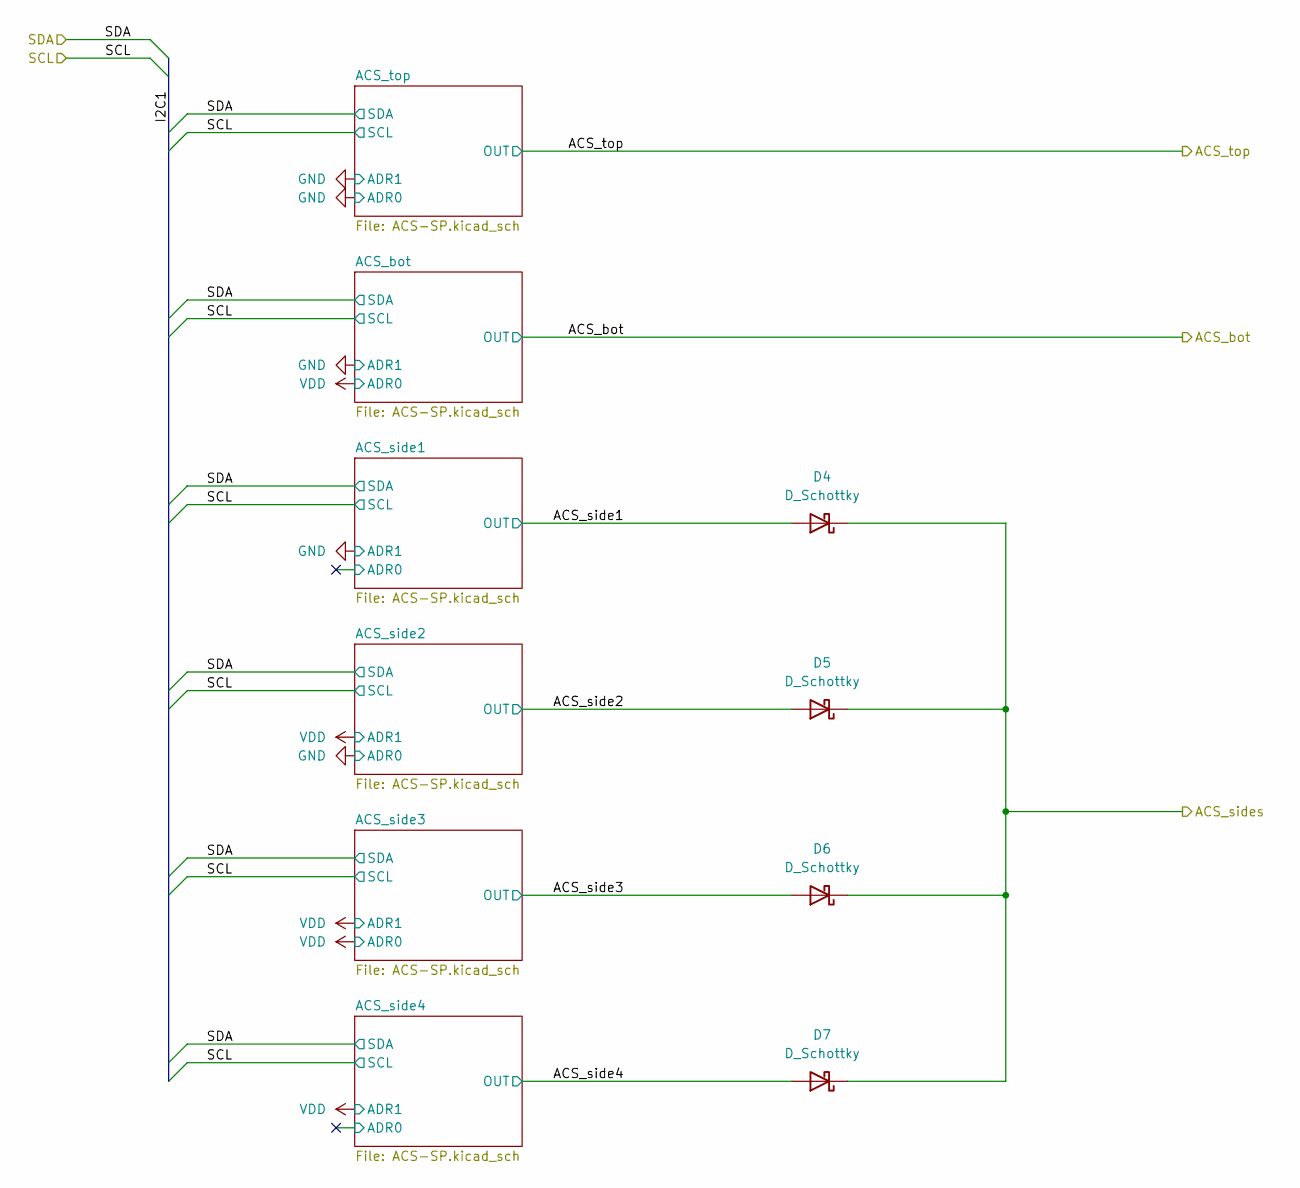
[picture p32: schematic ACS.kicad_sch]

Parts:
D4, D5, D6, D7: D_Schottky

Connections:
ACS_side1: D4.2 (A)
ACS_side2: D5.2 (A)
ACS_side3: D6.2 (A)
ACS_side4: D7.2 (A)
ACS_sides: D4.1 (K), D5.1 (K), D6.1 (K), D7.1 (K)
