sparkle-unitn/ELS-overall_schematic/DAQ-MCU.kicad_sch

## KiCad design DAQ-MCU.kicad_sch (2024-10-21)

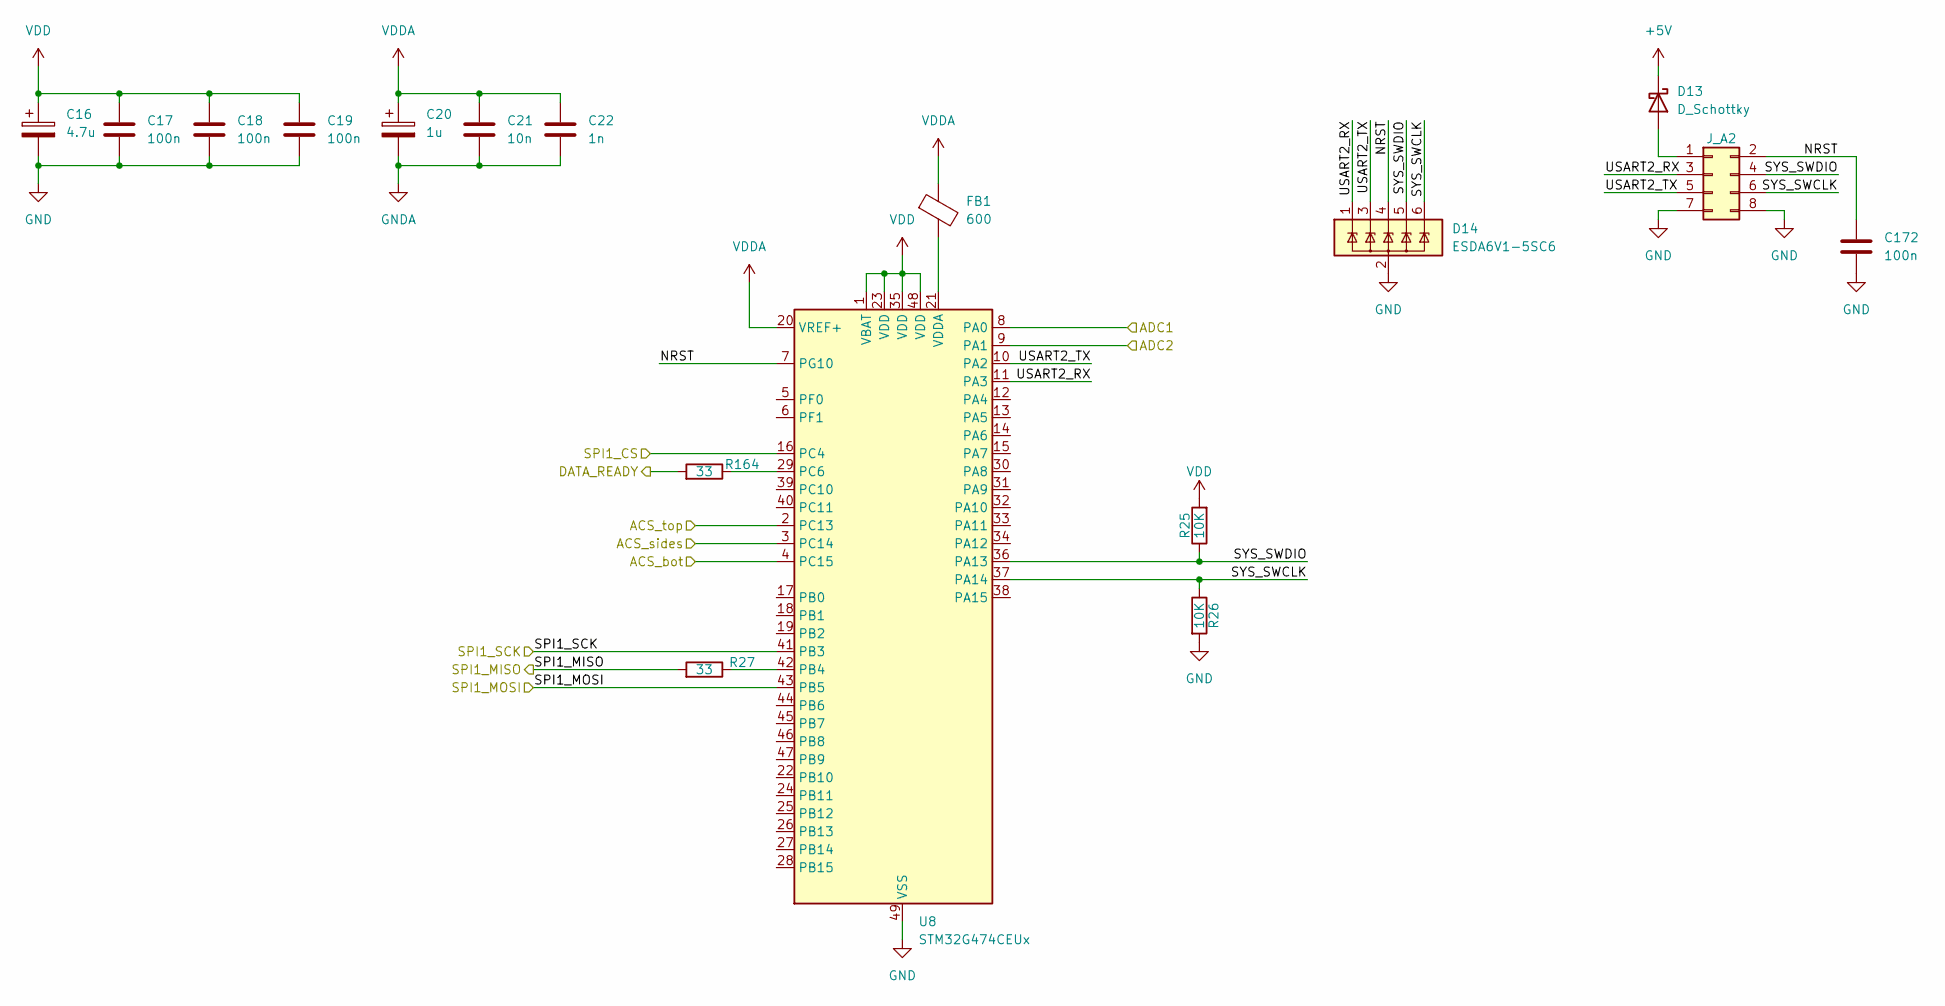
[picture p33: schematic DAQ-MCU.kicad_sch]

Parts:
C16: 4.7u
C17, C18, C19, C172: 100n
C20: 1u
C21: 10n
C22: 1n
D13: D_Schottky
D14: ESDA6V1-5SC6; SOT-23-6
FB1: 600
J_A2: Conn_02x05_Odd_Even; PinHeader_2x05_P2.54mm_Vertical
R25, R26: 10K; R_0603_1608Metric_Pad0.98x0.95mm_HandSolder
R27, R164: 33; R_0603_1608Metric_Pad0.98x0.95mm_HandSolder
U8: STM32G474CEUx; QFN-48-1EP_7x7mm_P0.5mm_EP5.6x5.6mm

Connections:
+5V: D13.1 (K)
ACS_bot: U8.4 (PC15)
ACS_sides: U8.3 (PC14)
ACS_top: U8.2 (PC13)
ADC1: U8.8 (PA0)
ADC2: U8.9 (PA1)
DATA_READY: R164.2
GND: C16.2, C17.2, C18.2, C19.2, C172.2, D14.2 (GND), J_A2.7, J_A2.8, R26.2, U8.49 (VSS)
GNDA: C20.2, C21.2, C22.2
NRST: C172.1, D14.4 (IO3), J_A2.2, U8.7 (PG10)
unnamed: D13.2 (A), J_A2.1
unnamed: FB1.2, U8.21 (VDDA)
unnamed: R27.1, U8.42 (PB4)
unnamed: R164.1, U8.29 (PC6)
SPI1_CS: U8.16 (PC4)
SPI1_MISO: R27.2
SPI1_MOSI: U8.43 (PB5)
SPI1_SCK: U8.41 (PB3)
SYS_SWCLK: D14.6 (IO5), J_A2.6, R26.1, U8.37 (PA14)
SYS_SWDIO: D14.5 (IO4), J_A2.4, R25.1, U8.36 (PA13)
USART2_RX: D14.1 (IO1), J_A2.3, U8.11 (PA3)
USART2_TX: D14.3 (IO2), J_A2.5, U8.10 (PA2)
VDD: C16.1, C17.1, C18.1, C19.1, R25.2, U8.1 (VBAT), U8.23 (VDD), U8.35 (VDD), U8.48 (VDD)
VDDA: C20.1, C21.1, C22.1, FB1.1, U8.20 (VREF+)
