sparkle-unitn/ELS-overall_schematic/DPCU.kicad_sch

## KiCad design DPCU.kicad_sch (2024-10-21)

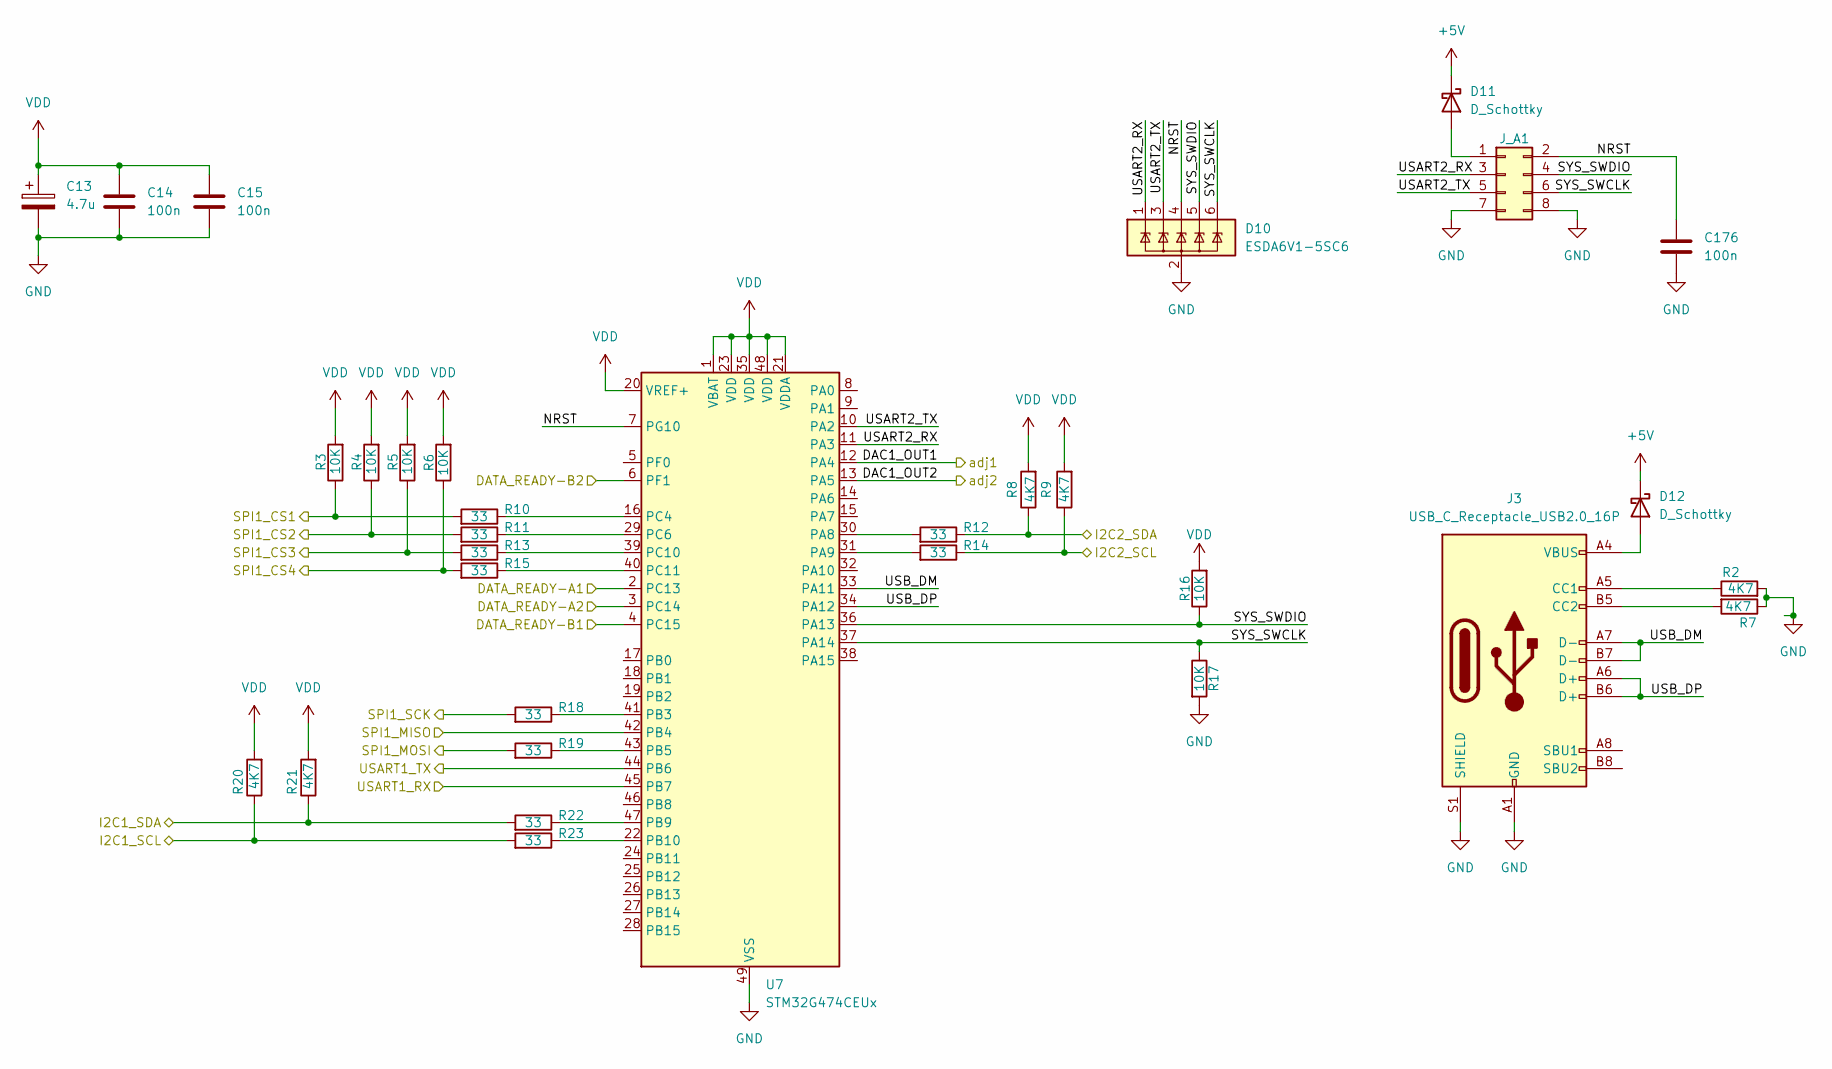
[picture p34: schematic DPCU.kicad_sch]

Parts:
C13: 4.7u
C14, C15, C176: 100n
D10: ESDA6V1-5SC6; SOT-23-6
D11, D12: D_Schottky
J3: USB_C_Receptacle_USB2.0_16P; USB_C_Receptacle_GCT_USB4085
J_A1: Conn_02x05_Odd_Even; PinHeader_2x05_P2.54mm_Vertical
R2, R7, R8, R9, R20, R21: 4K7; R_0603_1608Metric_Pad0.98x0.95mm_HandSolder
R3, R4, R5, R6, R16, R17: 10K; R_0603_1608Metric_Pad0.98x0.95mm_HandSolder
R10, R11, R12, R13, R14, R15, R18, R19, R22, R23: 33; R_0603_1608Metric_Pad0.98x0.95mm_HandSolder
U7: STM32G474CEUx; QFN-48-1EP_7x7mm_P0.5mm_EP5.6x5.6mm

Connections:
+5V: D11.1 (K), D12.1 (K)
DATA_READY-A1: U7.2 (PC13)
DATA_READY-A2: U7.3 (PC14)
DATA_READY-B1: U7.4 (PC15)
DATA_READY-B2: U7.6 (PF1)
GND: C13.2, C14.2, C15.2, C176.2, D10.2 (GND), J3.A1 (GND), J3.A12 (GND), J3.B1 (GND), J3.B12 (GND), J3.S1 (SHIELD), J_A1.7, J_A1.8, R2.2, R7.1, R17.2, U7.49 (VSS)
I2C1_SCL: R20.1, R23.2
I2C1_SDA: R21.1, R22.2
I2C2_SCL: R9.1, R14.1
I2C2_SDA: R8.1, R12.1
NRST: C176.1, D10.4 (IO3), J_A1.2, U7.7 (PG10)
unnamed: D11.2 (A), J_A1.1
unnamed: D12.2 (A), J3.A4 (VBUS), J3.A9 (VBUS), J3.B4 (VBUS), J3.B9 (VBUS)
unnamed: J3.A5 (CC1), R2.1
unnamed: J3.B5 (CC2), R7.2
unnamed: R10.1, U7.16 (PC4)
unnamed: R11.1, U7.29 (PC6)
unnamed: R12.2, U7.30 (PA8)
unnamed: R13.1, U7.39 (PC10)
unnamed: R14.2, U7.31 (PA9)
unnamed: R15.1, U7.40 (PC11)
unnamed: R18.1, U7.41 (PB3)
unnamed: R19.1, U7.43 (PB5)
unnamed: R22.1, U7.47 (PB9)
unnamed: R23.1, U7.22 (PB10)
SPI1_CS1: R3.1, R10.2
SPI1_CS2: R4.1, R11.2
SPI1_CS3: R5.1, R13.2
SPI1_CS4: R6.1, R15.2
SPI1_MISO: U7.42 (PB4)
SPI1_MOSI: R19.2
SPI1_SCK: R18.2
SYS_SWCLK: D10.6 (IO5), J_A1.6, R17.1, U7.37 (PA14)
SYS_SWDIO: D10.5 (IO4), J_A1.4, R16.1, U7.36 (PA13)
USART1_RX: U7.45 (PB7)
USART1_TX: U7.44 (PB6)
USART2_RX: D10.1 (IO1), J_A1.3, U7.11 (PA3)
USART2_TX: D10.3 (IO2), J_A1.5, U7.10 (PA2)
USB_DM: J3.A7 (D-), J3.B7 (D-), U7.33 (PA11)
USB_DP: J3.A6 (D+), J3.B6 (D+), U7.34 (PA12)
VDD: C13.1, C14.1, C15.1, R3.2, R4.2, R5.2, R6.2, R8.2, R9.2, R16.2, R20.2, R21.2, U7.1 (VBAT), U7.20 (VREF+), U7.21 (VDDA), U7.23 (VDD), U7.35 (VDD), U7.48 (VDD)
adj1: U7.12 (PA4)
adj2: U7.13 (PA5)
