sparkle-unitn/ELS-overall_schematic/ELS-overall_schematic.kicad_sch

## KiCad design ELS-overall_schematic.kicad_sch (2024-10-21)

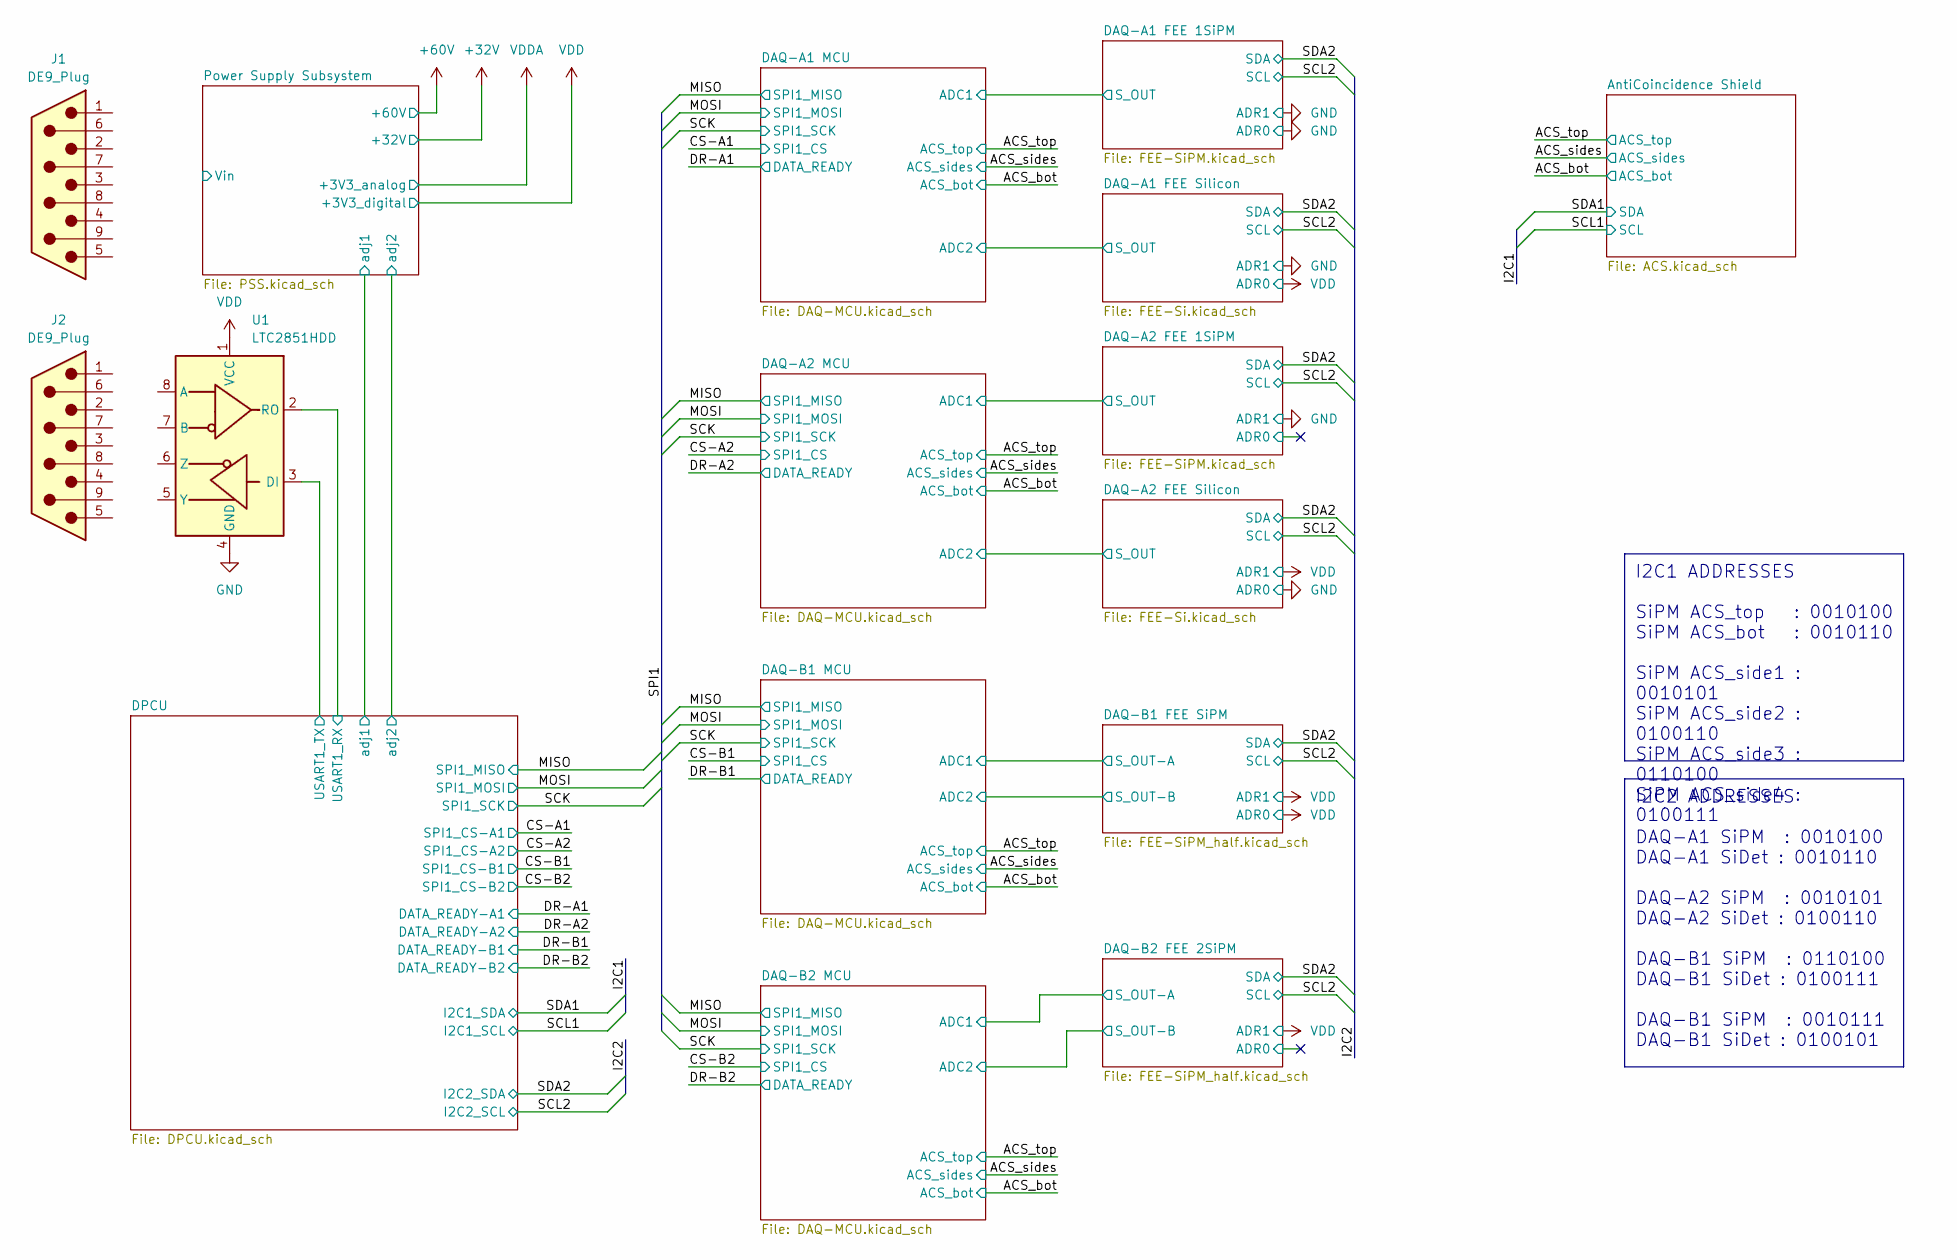
[picture p35: schematic ELS-overall_schematic.kicad_sch]

Parts:
J1, J2: DE9_Plug
U1: LTC2851HDD; DFN-8-1EP_3x3mm_P0.5mm_EP1.66x2.38mm

Connections:
GND: U1.4 (GND), U1.9 (GND)
USART1_RX: U1.2 (RO)
USART1_TX: U1.3 (DI)
VDD: U1.1 (VCC)

Notes on the sheet:
I2C2 ADDRESSES DAQ-A1 SiPM : 0010100 DAQ-A1 SiDet : 0010110 DAQ-A2 SiPM : 0010101 DAQ-A2 SiDet : 0100110 DAQ-B1 SiPM : 0110100 DAQ-B1 SiDet : 0100111 DAQ-B1 SiPM : 0010111 DAQ-B1 SiDet : 0100101
I2C1 ADDRESSES SiPM ACS_top : 0010100 SiPM ACS_bot : 0010110 SiPM ACS_side1 : 0010101 SiPM ACS_side2 : 0100110 SiPM ACS_side3 : 0110100 SiPM ACS_side4 : 0100111
