sparkle-unitn/ELS-overall_schematic/FEE-Si.kicad_sch

## KiCad design FEE-Si.kicad_sch (2024-10-21)

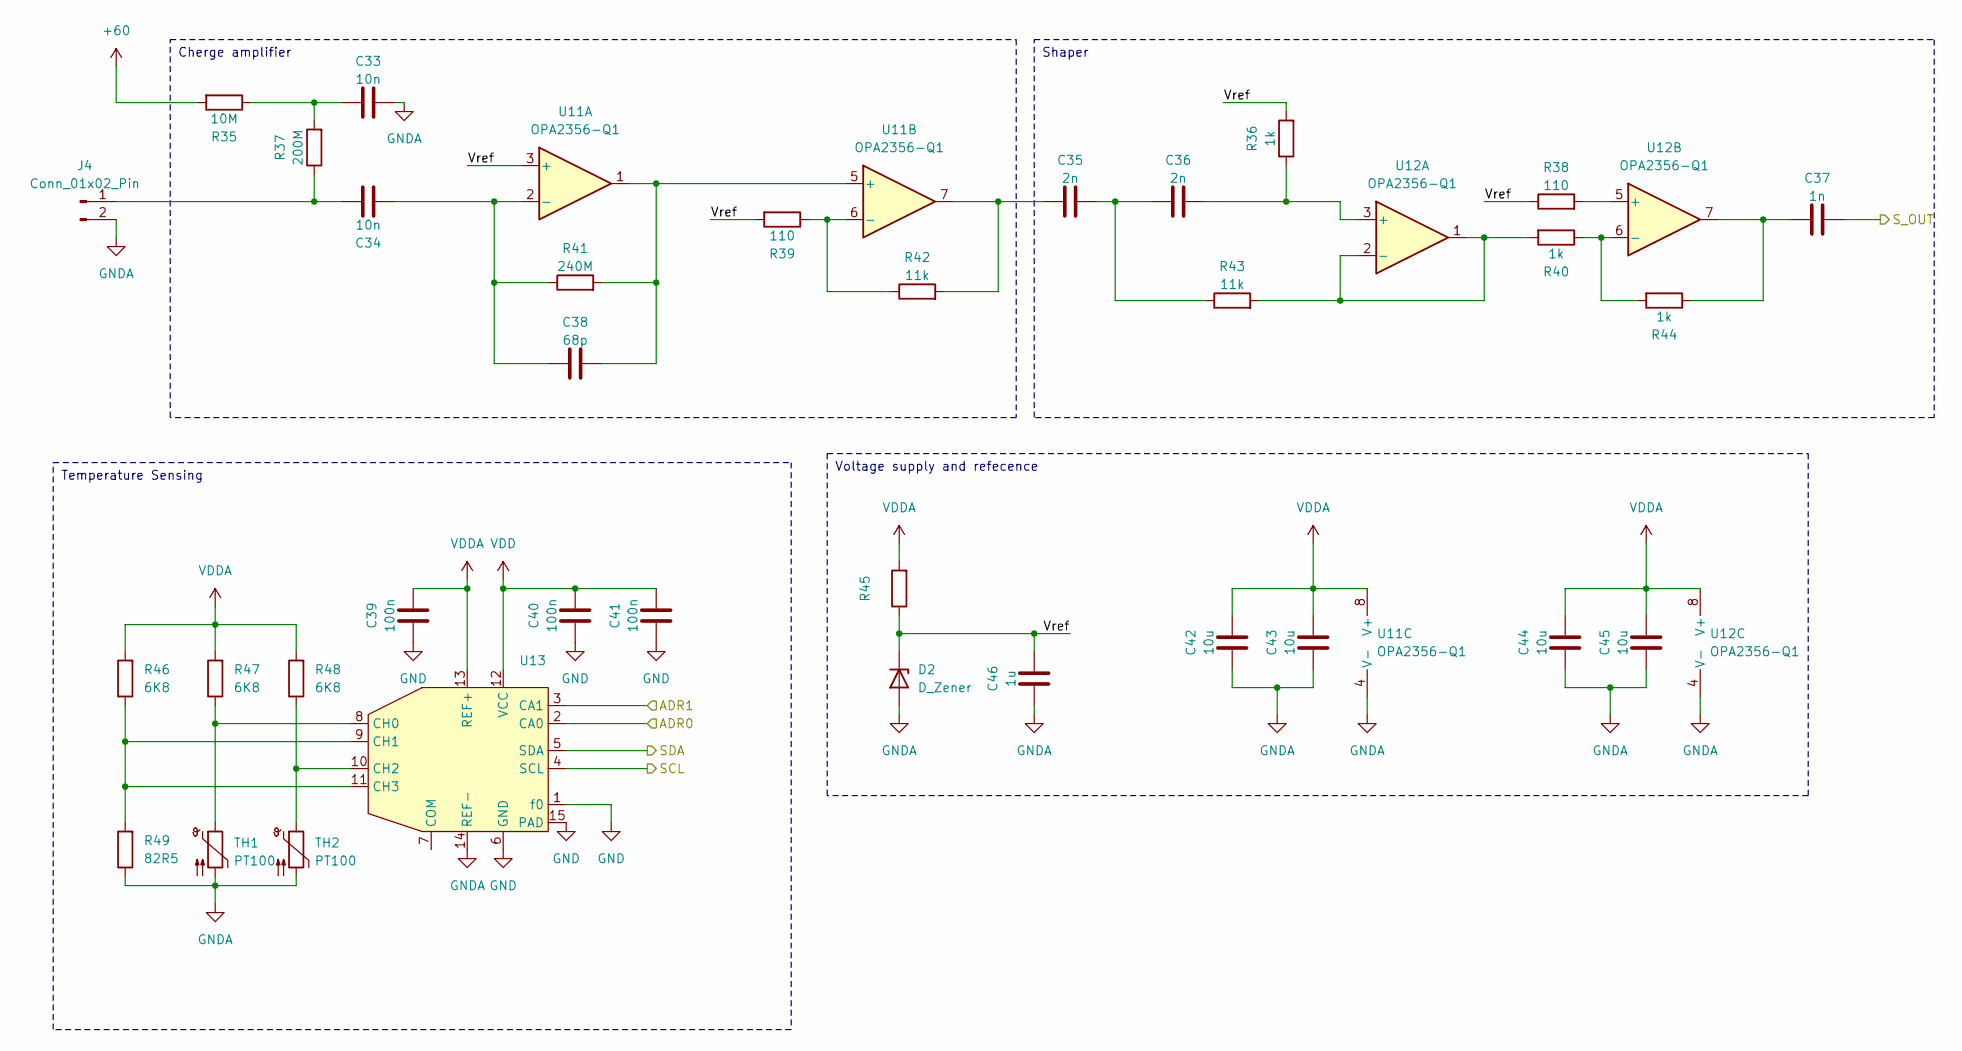
[picture p36: schematic FEE-Si.kicad_sch]

Parts:
C33, C34: 10n; C_0603_1608Metric_Pad1.08x0.95mm_HandSolder
C35, C36: 2n; C_0603_1608Metric_Pad1.08x0.95mm_HandSolder
C37: 1n; C_0603_1608Metric_Pad1.08x0.95mm_HandSolder
C38: 68p; C_0603_1608Metric_Pad1.08x0.95mm_HandSolder
C39, C40, C41: 100n; C_0603_1608Metric_Pad1.08x0.95mm_HandSolder
C42, C43, C44, C45: 10u; C_0603_1608Metric_Pad1.08x0.95mm_HandSolder
C46: 1u; C_0603_1608Metric_Pad1.08x0.95mm_HandSolder
D2: D_Zener
J4: Conn_01x02_Pin
R35: 10M; R_0603_1608Metric_Pad0.98x0.95mm_HandSolder
R36, R40, R44: 1k; R_0603_1608Metric_Pad0.98x0.95mm_HandSolder
R37: 200M; R_0603_1608Metric_Pad0.98x0.95mm_HandSolder
R38, R39: 110; R_0603_1608Metric_Pad0.98x0.95mm_HandSolder
R41: 240M; R_0603_1608Metric_Pad0.98x0.95mm_HandSolder
R42, R43: 11k; R_0603_1608Metric_Pad0.98x0.95mm_HandSolder
R45: R_0603_1608Metric_Pad0.98x0.95mm_HandSolder
R46, R47, R48: 6K8; R_0603_1608Metric_Pad0.98x0.95mm_HandSolder
R49: 82R5; R_0603_1608Metric_Pad0.98x0.95mm_HandSolder
TH1, TH2: PT100
U11, U12: OPA2356-Q1; LFCSP-8_2x2mm_P0.5mm
U13: (no value)

Connections:
+60: R35.2
ADR0: U13.2 (CA0)
ADR1: U13.3 (CA1)
GND: C39.1, C40.1, C41.1, U13.1 (f0), U13.6 (GND), U13.15 (PAD)
GNDA: C33.2, C42.1, C43.1, C44.1, C45.1, C46.1, D2.2 (A), J4.2, R49.1, TH1.2, TH2.2, U11.4 (V-), U12.4 (V-), U13.14 (REF-)
unnamed: C33.1, R35.1, R37.2
unnamed: C34.1, C38.1, R41.1, U11.2 (-)
unnamed: C34.2, J4.1, R37.1
unnamed: C35.1, R42.2, U11.7
unnamed: C35.2, C36.1, R43.1
unnamed: C36.2, R36.1, U12.3 (+)
unnamed: C37.1, R44.1, U12.7
unnamed: C38.2, R41.2, U11.1, U11.5 (+)
unnamed: R38.2, U12.5 (+)
unnamed: R39.1, R42.1, U11.6 (-)
unnamed: R40.1, R44.2, U12.6 (-)
unnamed: R40.2, R43.2, U12.1, U12.2 (-)
unnamed: R46.1, R49.2, U13.9 (CH1), U13.11 (CH3)
unnamed: R47.1, TH1.1, U13.8 (CH0)
unnamed: R48.1, TH2.1, U13.10 (CH2)
SCL: U13.4 (SCL)
SDA: U13.5 (SDA)
S_OUT: C37.2
VDD: C40.2, C41.2, U13.12 (VCC)
VDDA: C39.2, C42.2, C43.2, C44.2, C45.2, R45.2, R46.2, R47.2, R48.2, U11.8 (V+), U12.8 (V+), U13.13 (REF+)
Vref: C46.2, D2.1 (K), R36.2, R38.1, R39.2, R45.1, U11.3 (+)

Notes on the sheet:
Voltage supply and refecence
Cherge amplifier
Shaper
Temperature Sensing
