sparkle-unitn/ELS-overall_schematic/FEE-SiPM.kicad_sch

## KiCad design FEE-SiPM.kicad_sch (2024-10-17)

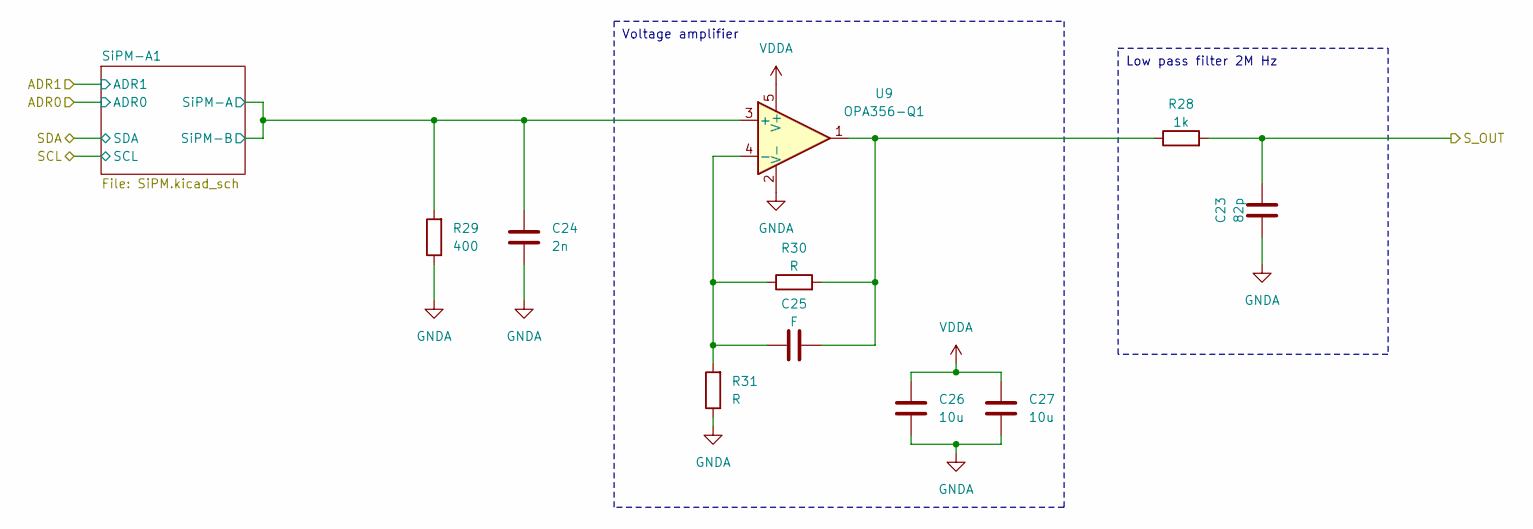
[picture p37: schematic FEE-SiPM.kicad_sch]

Parts:
C23: 82p; C_0603_1608Metric_Pad1.08x0.95mm_HandSolder
C24: 2n; C_0603_1608Metric_Pad1.08x0.95mm_HandSolder
C25: F; C_0603_1608Metric_Pad1.08x0.95mm_HandSolder
C26, C27: 10u
R28: 1k; R_0603_1608Metric_Pad0.98x0.95mm_HandSolder
R29: 400; R_0603_1608Metric_Pad0.98x0.95mm_HandSolder
R30, R31: R; R_0603_1608Metric_Pad0.98x0.95mm_HandSolder
U9: OPA356-Q1; SOT-23-5

Connections:
GNDA: C23.1, C24.1, C26.2, C27.2, R29.1, R31.1, U9.2 (V-)
unnamed: C25.1, R30.1, R31.2, U9.4 (-)
unnamed: C25.2, R28.1, R30.2, U9.1
S_OUT: C23.2, R28.2
SiPM-A: C24.2, R29.2, U9.3 (+)
VDDA: C26.1, C27.1, U9.5 (V+)

Notes on the sheet:
Low pass filter 2M Hz
Voltage amplifier
