sparkle-unitn/ELS-overall_schematic/FEE-SiPM_half.kicad_sch

## KiCad design FEE-SiPM_half.kicad_sch (2024-10-17)

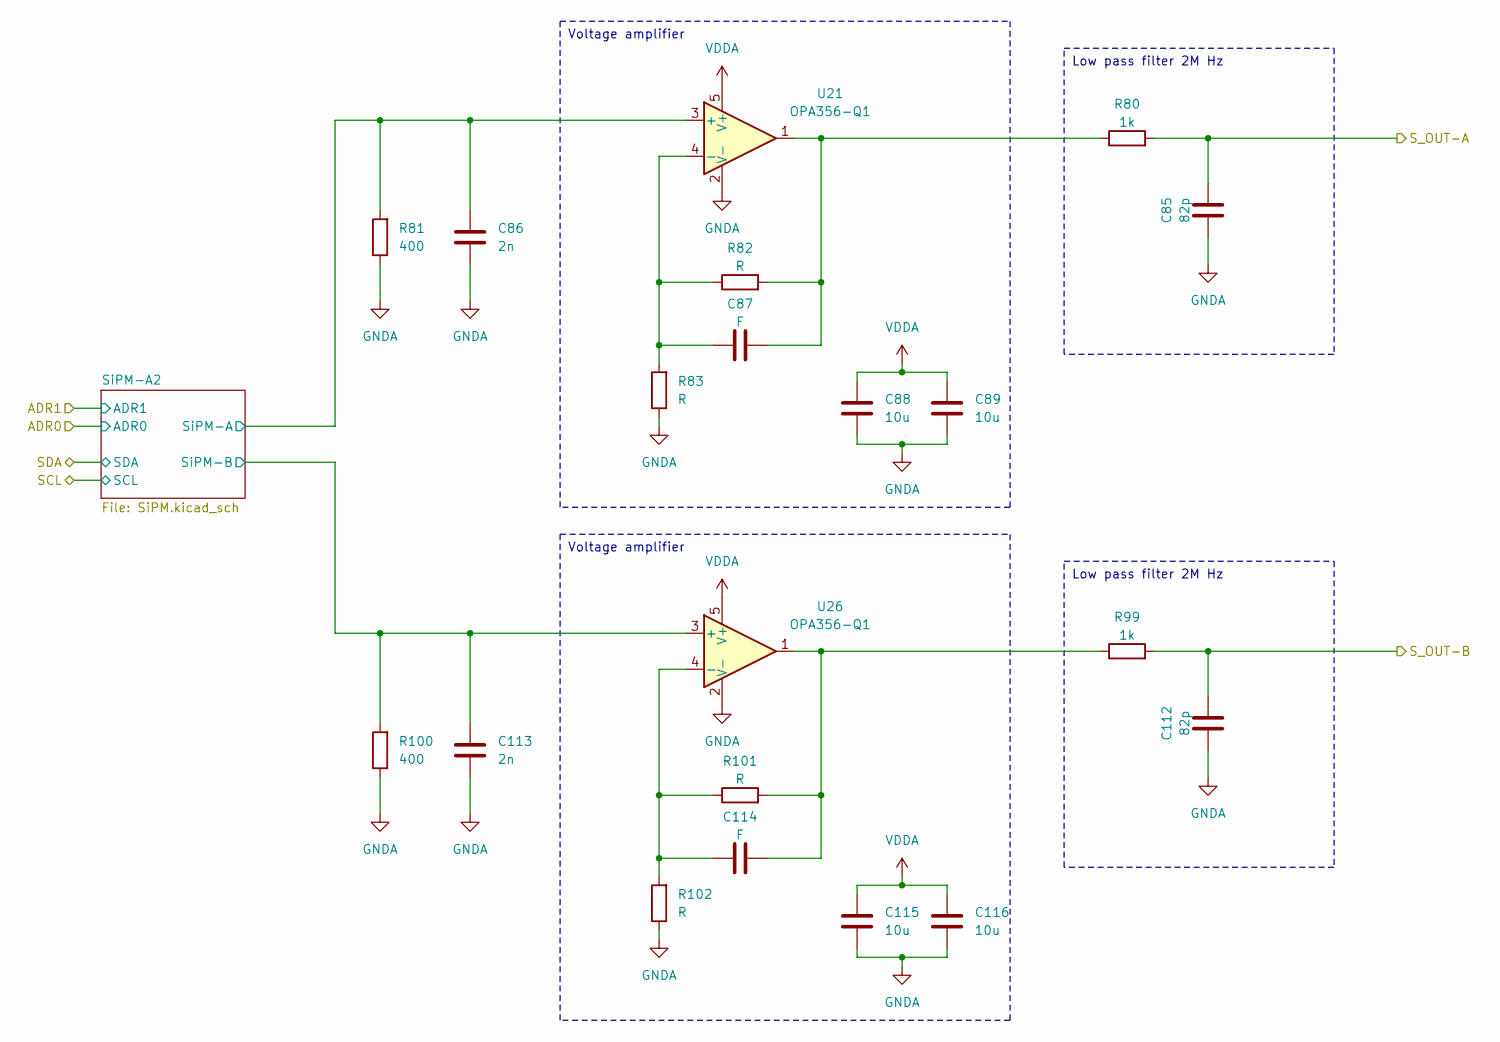
[picture p38: schematic FEE-SiPM_half.kicad_sch]

Parts:
C85, C112: 82p; C_0603_1608Metric_Pad1.08x0.95mm_HandSolder
C86, C113: 2n; C_0603_1608Metric_Pad1.08x0.95mm_HandSolder
C87, C114: F; C_0603_1608Metric_Pad1.08x0.95mm_HandSolder
C88, C89, C115, C116: 10u
R80, R99: 1k; R_0603_1608Metric_Pad0.98x0.95mm_HandSolder
R81, R100: 400; R_0603_1608Metric_Pad0.98x0.95mm_HandSolder
R82, R83, R101, R102: R; R_0603_1608Metric_Pad0.98x0.95mm_HandSolder
U21, U26: OPA356-Q1; SOT-23-5

Connections:
GNDA: C85.1, C86.1, C88.2, C89.2, C112.1, C113.1, C115.2, C116.2, R81.1, R83.1, R100.1, R102.1, U21.2 (V-), U26.2 (V-)
unnamed: C87.1, R82.1, R83.2, U21.4 (-)
unnamed: C87.2, R80.1, R82.2, U21.1
unnamed: C114.1, R101.1, R102.2, U26.4 (-)
unnamed: C114.2, R99.1, R101.2, U26.1
S_OUT-A: C85.2, R80.2
S_OUT-B: C112.2, R99.2
SiPM-A: C86.2, R81.2, U21.3 (+)
SiPM-B: C113.2, R100.2, U26.3 (+)
VDDA: C88.1, C89.1, C115.1, C116.1, U21.5 (V+), U26.5 (V+)

Notes on the sheet:
Low pass filter 2M Hz
Voltage amplifier
