sparkle-unitn/ELS-overall_schematic/PSS.kicad_sch

## KiCad design PSS.kicad_sch (2024-10-21)

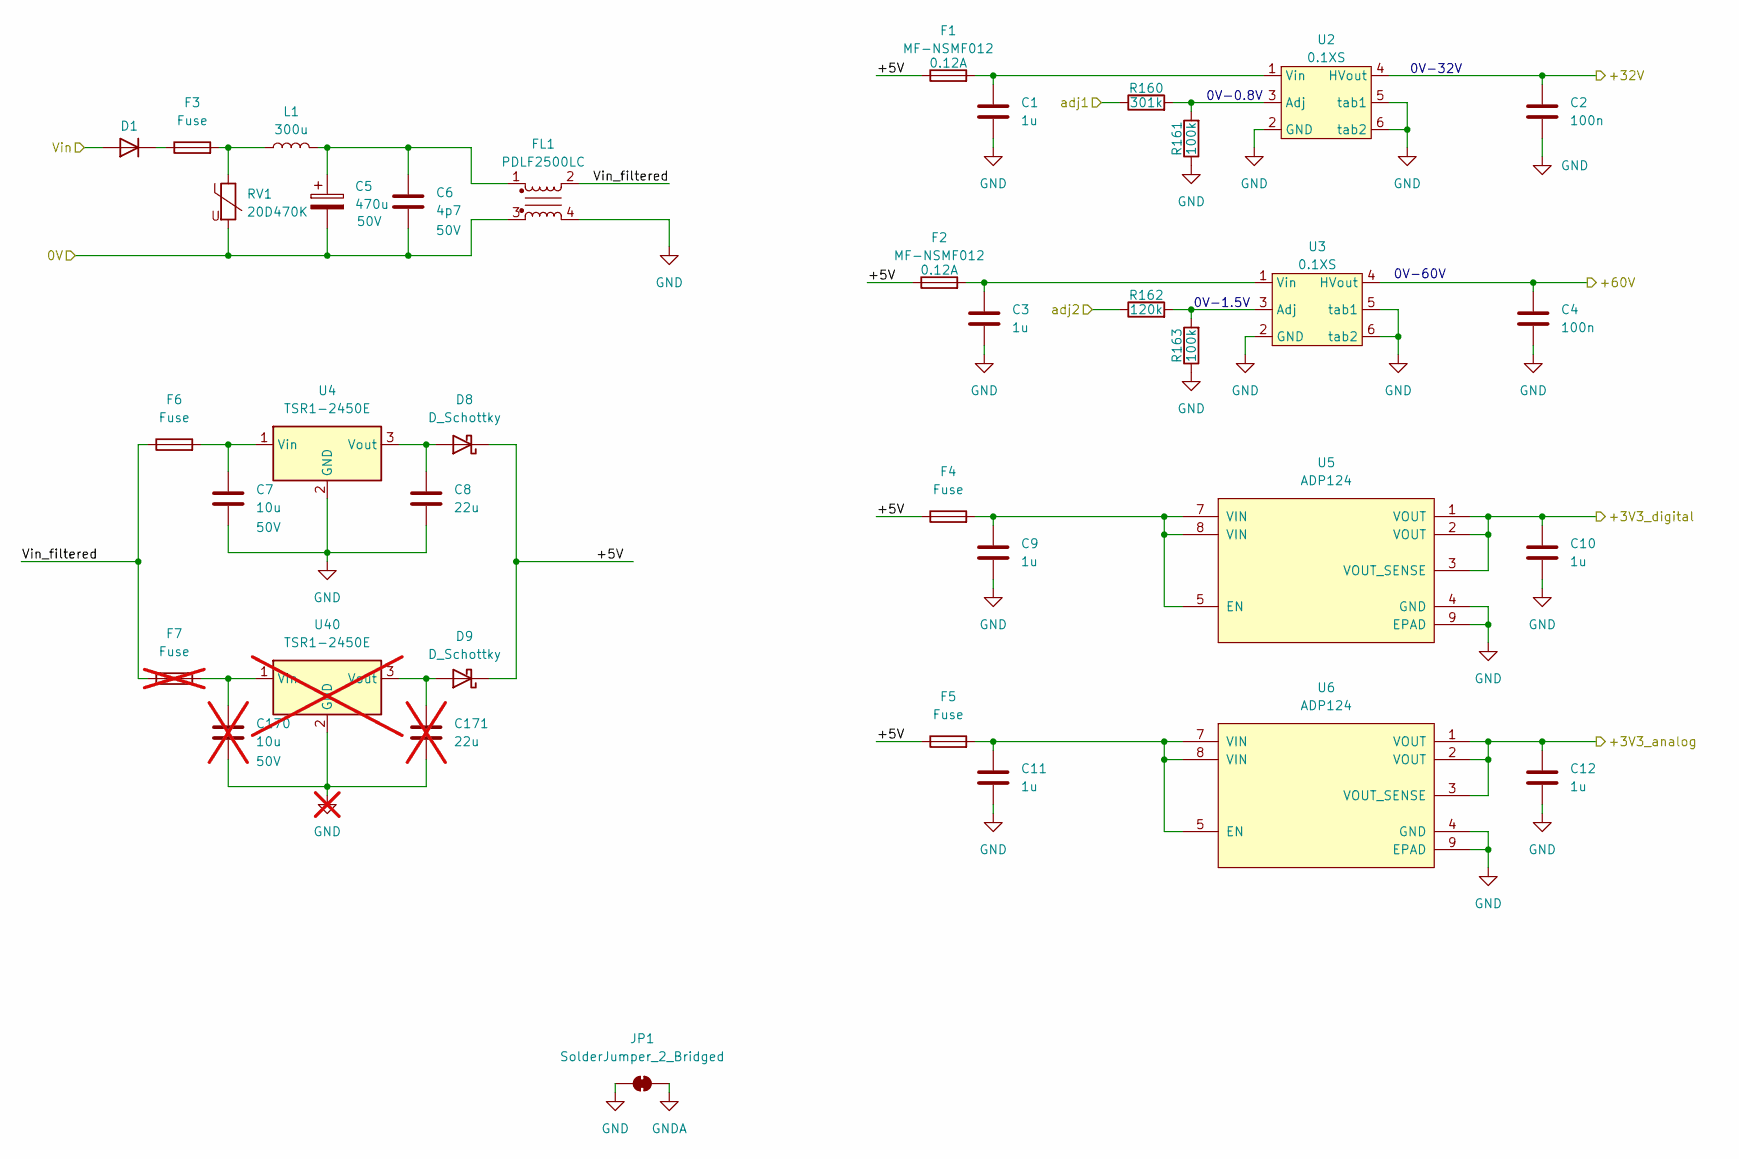
[picture p39: schematic PSS.kicad_sch]

Parts:
C1, C3, C9, C10, C11, C12: 1u
C2, C4: 100n
C5: 470u; Voltage 50V
C6: 4p7; Voltage 50V
C7: 10u; Voltage 50V
C8: 22u
C170: 10u; Voltage 50V; not fitted
C171: 22u; not fitted
D1: D
D8, D9: D_Schottky
F1, F2: MF-NSMF012
F3, F4, F5, F6: Fuse
F7: Fuse; not fitted
FL1: PDLF2500LC; L_CommonModeChoke_TDK_ACM2520-3P
JP1: SolderJumper_2_Bridged; SolderJumper-2_P1.3mm_Bridged2Bar_Pad1.0x1.5mm
L1: 300u
R160: 301k; R_0603_1608Metric_Pad0.98x0.95mm_HandSolder
R161, R163: 100k; R_0603_1608Metric_Pad0.98x0.95mm_HandSolder
R162: 120k; R_0603_1608Metric_Pad0.98x0.95mm_HandSolder
RV1: 20D470K
U2, U3: 0.1XS
U4: TSR1-2450E; Converter_DCDC_TRACO_TSR1-xxxxE_THT
U5, U6: ADP124; SON50P200X200X60-9N
U40: TSR1-2450E; Converter_DCDC_TRACO_TSR1-xxxxE_THT; not fitted

Connections:
0V: C5.2, C6.2, FL1.3, RV1.2
+3V3_analog: C12.1, U6.1 (VOUT), U6.2 (VOUT), U6.3 (VOUT_SENSE)
+3V3_digital: C10.1, U5.1 (VOUT), U5.2 (VOUT), U5.3 (VOUT_SENSE)
+5V: D8.1 (K), D9.1 (K), F1.1, F2.1, F4.1, F5.1
+32V: C2.1, U2.4 (HVout)
+60V: C4.1, U3.4 (HVout)
GND: C1.2, C2.2, C3.2, C4.2, C7.2, C8.2, C9.2, C10.2, C11.2, C12.2, C170.2, C171.2, FL1.4, JP1.1 (A), R161.1, R163.1, U2.2 (GND), U2.5 (tab1), U2.6 (tab2), U3.2 (GND), U3.5 (tab1), U3.6 (tab2), U4.2 (GND), U5.4 (GND), U5.9 (EPAD), U6.4 (GND), U6.9 (EPAD), U40.2 (GND)
GNDA: JP1.2 (B)
unnamed: C1.1, F1.2, U2.1 (Vin)
unnamed: C3.1, F2.2, U3.1 (Vin)
unnamed: C5.1, C6.1, FL1.1, L1.2
unnamed: C7.1, F6.2, U4.1 (Vin)
unnamed: C8.1, D8.2 (A), U4.3 (Vout)
unnamed: C9.1, F4.2, U5.5 (EN), U5.7 (VIN), U5.8 (VIN)
unnamed: C11.1, F5.2, U6.5 (EN), U6.7 (VIN), U6.8 (VIN)
unnamed: C170.1, F7.2, U40.1 (Vin)
unnamed: C171.1, D9.2 (A), U40.3 (Vout)
unnamed: D1.1 (K), F3.1
unnamed: F3.2, L1.1, RV1.1
unnamed: R160.2, R161.2, U2.3 (Adj)
unnamed: R162.2, R163.2, U3.3 (Adj)
Vin: D1.2 (A)
Vin_filtered: F6.1, F7.1, FL1.2
adj1: R160.1
adj2: R162.1

Notes on the sheet:
0V-1.5V
0V-0.8V
0V-32V
0V-60V
