sparkle-unitn/ELS-overall_schematic/SiPM.kicad_sch

## KiCad design SiPM.kicad_sch (2024-10-21)

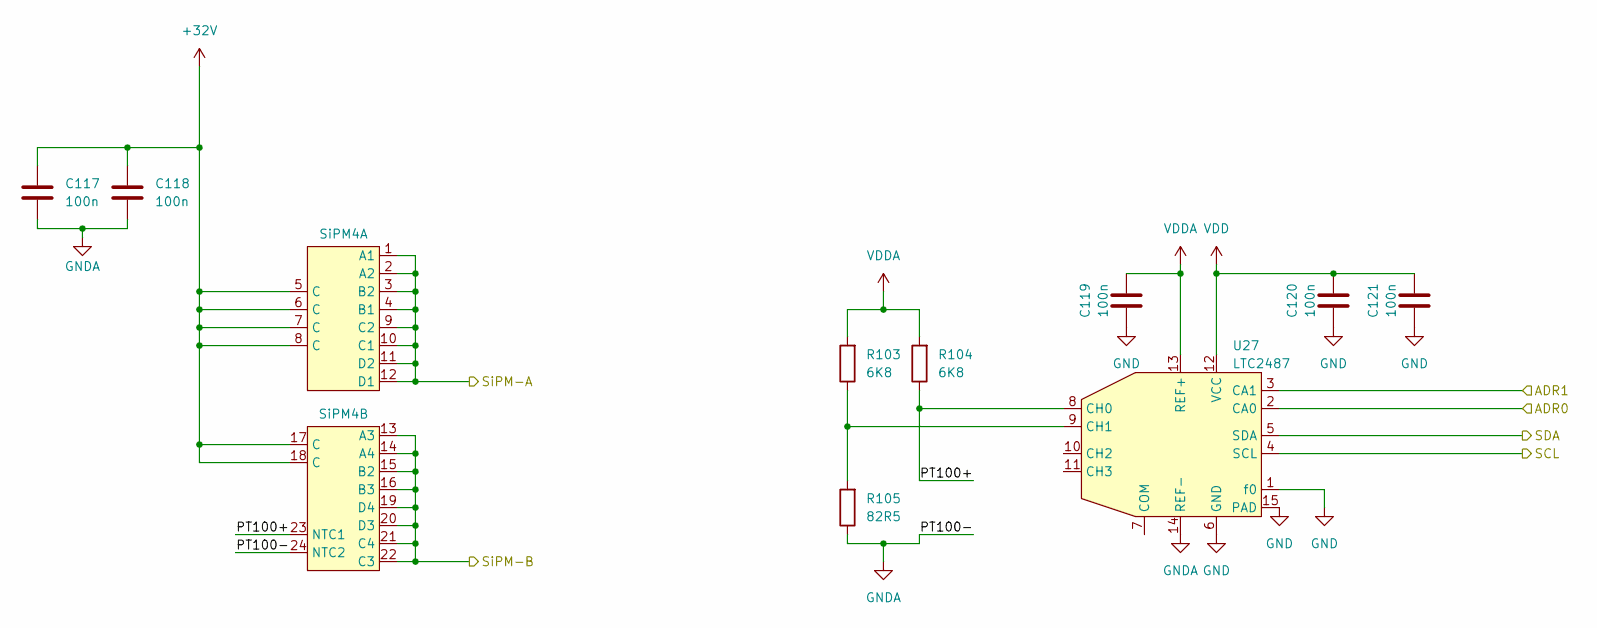
[picture p40: schematic SiPM.kicad_sch]

Parts:
C117, C118: 100n
C119, C120, C121: 100n; C_0603_1608Metric_Pad1.08x0.95mm_HandSolder
R103, R104: 6K8; R_0603_1608Metric_Pad0.98x0.95mm_HandSolder
R105: 82R5; R_0603_1608Metric_Pad0.98x0.95mm_HandSolder
SiPM4: (no value)
U27: LTC2487

Connections:
+32V: C117.1, C118.1, SiPM4.5 (C), SiPM4.6 (C), SiPM4.7 (C), SiPM4.8 (C), SiPM4.17 (C), SiPM4.18 (C)
ADR0: U27.2 (CA0)
ADR1: U27.3 (CA1)
GND: C119.1, C120.1, C121.1, U27.1 (f0), U27.6 (GND), U27.15 (PAD)
GNDA: C117.2, C118.2, R105.1, SiPM4.24 (NTC2), U27.14 (REF-)
unnamed: R103.1, R105.2, U27.9 (CH1)
PT100+: R104.1, SiPM4.23 (NTC1), U27.8 (CH0)
SCL: U27.4 (SCL)
SDA: U27.5 (SDA)
SiPM-A: SiPM4.1 (A1), SiPM4.2 (A2), SiPM4.3 (B2), SiPM4.4 (B1), SiPM4.9 (C2), SiPM4.10 (C1), SiPM4.11 (D2), SiPM4.12 (D1)
SiPM-B: SiPM4.13 (A3), SiPM4.14 (A4), SiPM4.15 (B2), SiPM4.16 (B3), SiPM4.19 (D4), SiPM4.20 (D3), SiPM4.21 (C4), SiPM4.22 (C3)
VDD: C120.2, C121.2, U27.12 (VCC)
VDDA: C119.2, R103.2, R104.2, U27.13 (REF+)
