sparkle-unitn/ELS-overall_schematic/DPCU_pinout.ioc

Mcu.UserName=STM32G474CEUx
PA0.Signal=ADC1_IN1
PA1.Signal=ADC2_IN2
PA11.Signal=USB_DM
PA12.Signal=USB_DP
PA13.Signal=SYS_JTMS-SWDIO
PA14.Signal=SYS_JTCK-SWCLK
PA4.Signal=GPXTI4
PA5.Signal=GPXTI5
PA6.Signal=GPXTI6
PA7.Signal=GPXTI7
PA8.Signal=I2C2_SDA
PA9.Signal=I2C2_SCL
PB10.Signal=GPXTI10
PB3.Signal=SPI1_SCK
PB4.Signal=SPI1_MISO
PB5.Signal=SPI1_MOSI
PB6.Signal=USART1_TX
PB7.Signal=USART1_RX
PB8-BOOT0.Signal=I2C1_SCL
PB9.Signal=I2C1_SDA
PC13.Signal=GPXTI13
PC14-OSC32_IN.Signal=GPXTI14
PC15-OSC32_OUT.Signal=GPXTI15
PC4.Signal=GPIO_Output
PC6.Signal=GPIO_Output
PF1-OSC_OUT.Signal=GPXTI1
