sparkle-unitn/ELS-overall_schematic/(commit log)

2024-10-17 first release
    [ACS-SP.kicad_sch, ACS.kicad_sch, DAQ-MCU.kicad_sch, DPCU.kicad_sch, ELS-overall_schematic.kicad_sch, FEE-Si.kicad_sch, FEE-SiPM.kicad_sch, FEE-SiPM_half.kicad_sch]
2024-10-19 Add voltage divider for adj signals
    [DPCU.kicad_sch, ELS-overall_schematic.kicad_sch]
2024-10-21 adj divider signal
    [PSS.kicad_sch]
2024-10-21 5V dcdc redundancy
    [PSS.kicad_sch]
2024-10-21 data ready signals
    [DAQ-MCU.kicad_sch, DPCU.kicad_sch, ELS-overall_schematic.kicad_sch, PSS.kicad_sch]
2024-10-21 gnd and gnda
    [DAQ-MCU.kicad_sch, DPCU.kicad_sch, FEE-Si.kicad_sch, PSS.kicad_sch, SiPM.kicad_sch]
